srfunksensei/MIPS/(list of files, cad)

Other CAD files:
source/8051/program8051/STARTUP.OBJ
source/8051/program8051/program8051.OBJ
source/8051/program8051/program.OBJ
