srfunksensei/MIPS/source/8051/kasa8051/16_segmentLED.sch

## KiCad design source/8051/kasa8051/16_segmentLED.sch (2018-07-15)

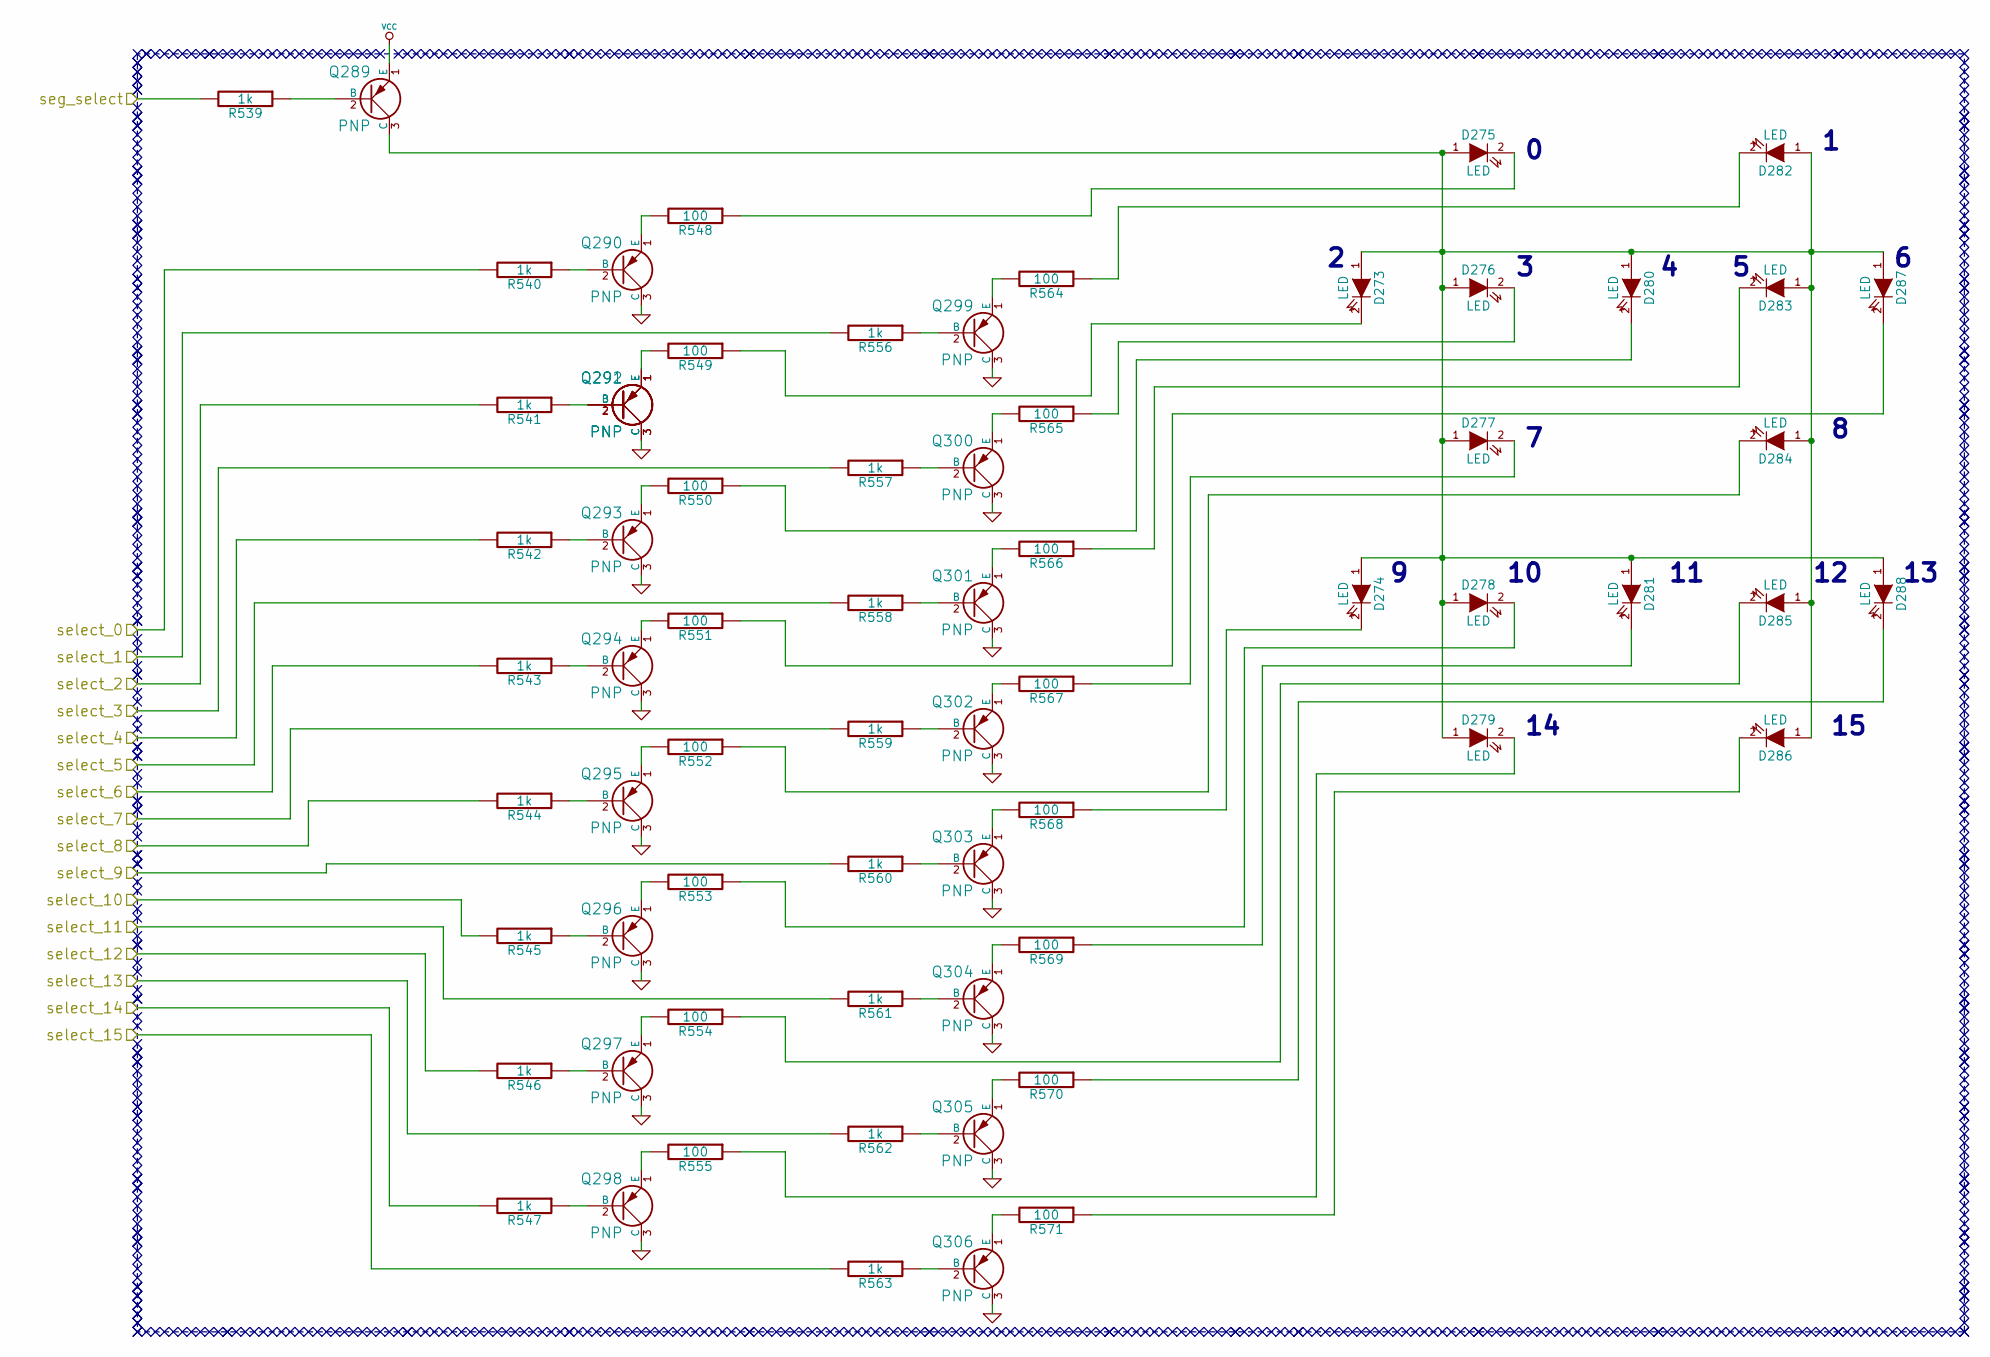
[picture p5: schematic 16_segmentLED.sch]

Parts:
D273, D274, D275, D276, D277, D278, D279, D280, D281, D282, D283, D284, D285, D286, D287, D288: LED
Q289, Q290, Q291, Q292, Q293, Q294, Q295, Q296, Q297, Q298, Q299, Q300, Q301, Q302, Q303, Q304, Q305, Q306: PNP
R539, R540, R541, R542, R543, R544, R545, R546, R547, R556, R557, R558, R559, R560, R561, R562, R563: 1k
R548, R549, R550, R551, R552, R553, R554, R555, R564, R565, R566, R567, R568, R569, R570, R571: 100

Connections:
GNDA: Q290.3 (C), Q291.3 (C), Q292.3 (C), Q293.3 (C), Q294.3 (C), Q295.3 (C), Q296.3 (C), Q297.3 (C), Q298.3 (C), Q299.3 (C), Q300.3 (C), Q301.3 (C), Q302.3 (C), Q303.3 (C), Q304.3 (C), Q305.3 (C), Q306.3 (C)
unnamed: D273.1 (A), D274.1 (A), D275.1 (A), D276.1 (A), D277.1 (A), D278.1 (A), D279.1 (A), D280.1 (A), D281.1 (A), D282.1 (A), D283.1 (A), D284.1 (A), D285.1 (A), D286.1 (A), D287.1 (A), D288.1 (A), Q289.3 (C)
unnamed: D273.2 (K), R549.1
unnamed: D274.2 (K), R568.1
unnamed: D275.2 (K), R548.1
unnamed: D276.2 (K), R565.1
unnamed: D277.2 (K), R567.1
unnamed: D278.2 (K), R553.1
unnamed: D279.2 (K), R555.1
unnamed: D280.2 (K), R550.1
unnamed: D281.2 (K), R569.1
unnamed: D282.2 (K), R564.1
unnamed: D283.2 (K), R566.1
unnamed: D284.2 (K), R552.1
unnamed: D285.2 (K), R554.1
unnamed: D286.2 (K), R571.1
unnamed: D287.2 (K), R551.1
unnamed: D288.2 (K), R570.1
unnamed: Q289.2 (B), R539.1
unnamed: Q290.1 (E), R548.2
unnamed: Q290.2 (B), R540.1
unnamed: Q291.1 (E), Q292.1 (E), R549.2
unnamed: Q291.2 (B), Q292.2 (B), R541.1
unnamed: Q293.1 (E), R550.2
unnamed: Q293.2 (B), R542.1
unnamed: Q294.1 (E), R551.2
unnamed: Q294.2 (B), R543.1
unnamed: Q295.1 (E), R552.2
unnamed: Q295.2 (B), R544.1
unnamed: Q296.1 (E), R553.2
unnamed: Q296.2 (B), R545.1
unnamed: Q297.1 (E), R554.2
unnamed: Q297.2 (B), R546.1
unnamed: Q298.1 (E), R555.2
unnamed: Q298.2 (B), R547.1
unnamed: Q299.1 (E), R564.2
unnamed: Q299.2 (B), R556.1
unnamed: Q300.1 (E), R565.2
unnamed: Q300.2 (B), R557.1
unnamed: Q301.1 (E), R566.2
unnamed: Q301.2 (B), R558.1
unnamed: Q302.1 (E), R567.2
unnamed: Q302.2 (B), R559.1
unnamed: Q303.1 (E), R568.2
unnamed: Q303.2 (B), R560.1
unnamed: Q304.1 (E), R569.2
unnamed: Q304.2 (B), R561.1
unnamed: Q305.1 (E), R570.2
unnamed: Q305.2 (B), R562.1
unnamed: Q306.1 (E), R571.2
unnamed: Q306.2 (B), R563.1
VCC: Q289.1 (E)
seg_select: R539.2
select_0: R540.2
select_1: R556.2
select_2: R541.2
select_3: R557.2
select_4: R542.2
select_5: R558.2
select_6: R543.2
select_7: R559.2
select_8: R544.2
select_9: R560.2
select_10: R545.2
select_11: R561.2
select_12: R546.2
select_13: R562.2
select_14: R547.2
select_15: R563.2
