srfunksensei/MIPS/source/8051/kasa8051/8051.sch

## KiCad design source/8051/kasa8051/8051.sch (2018-07-15)

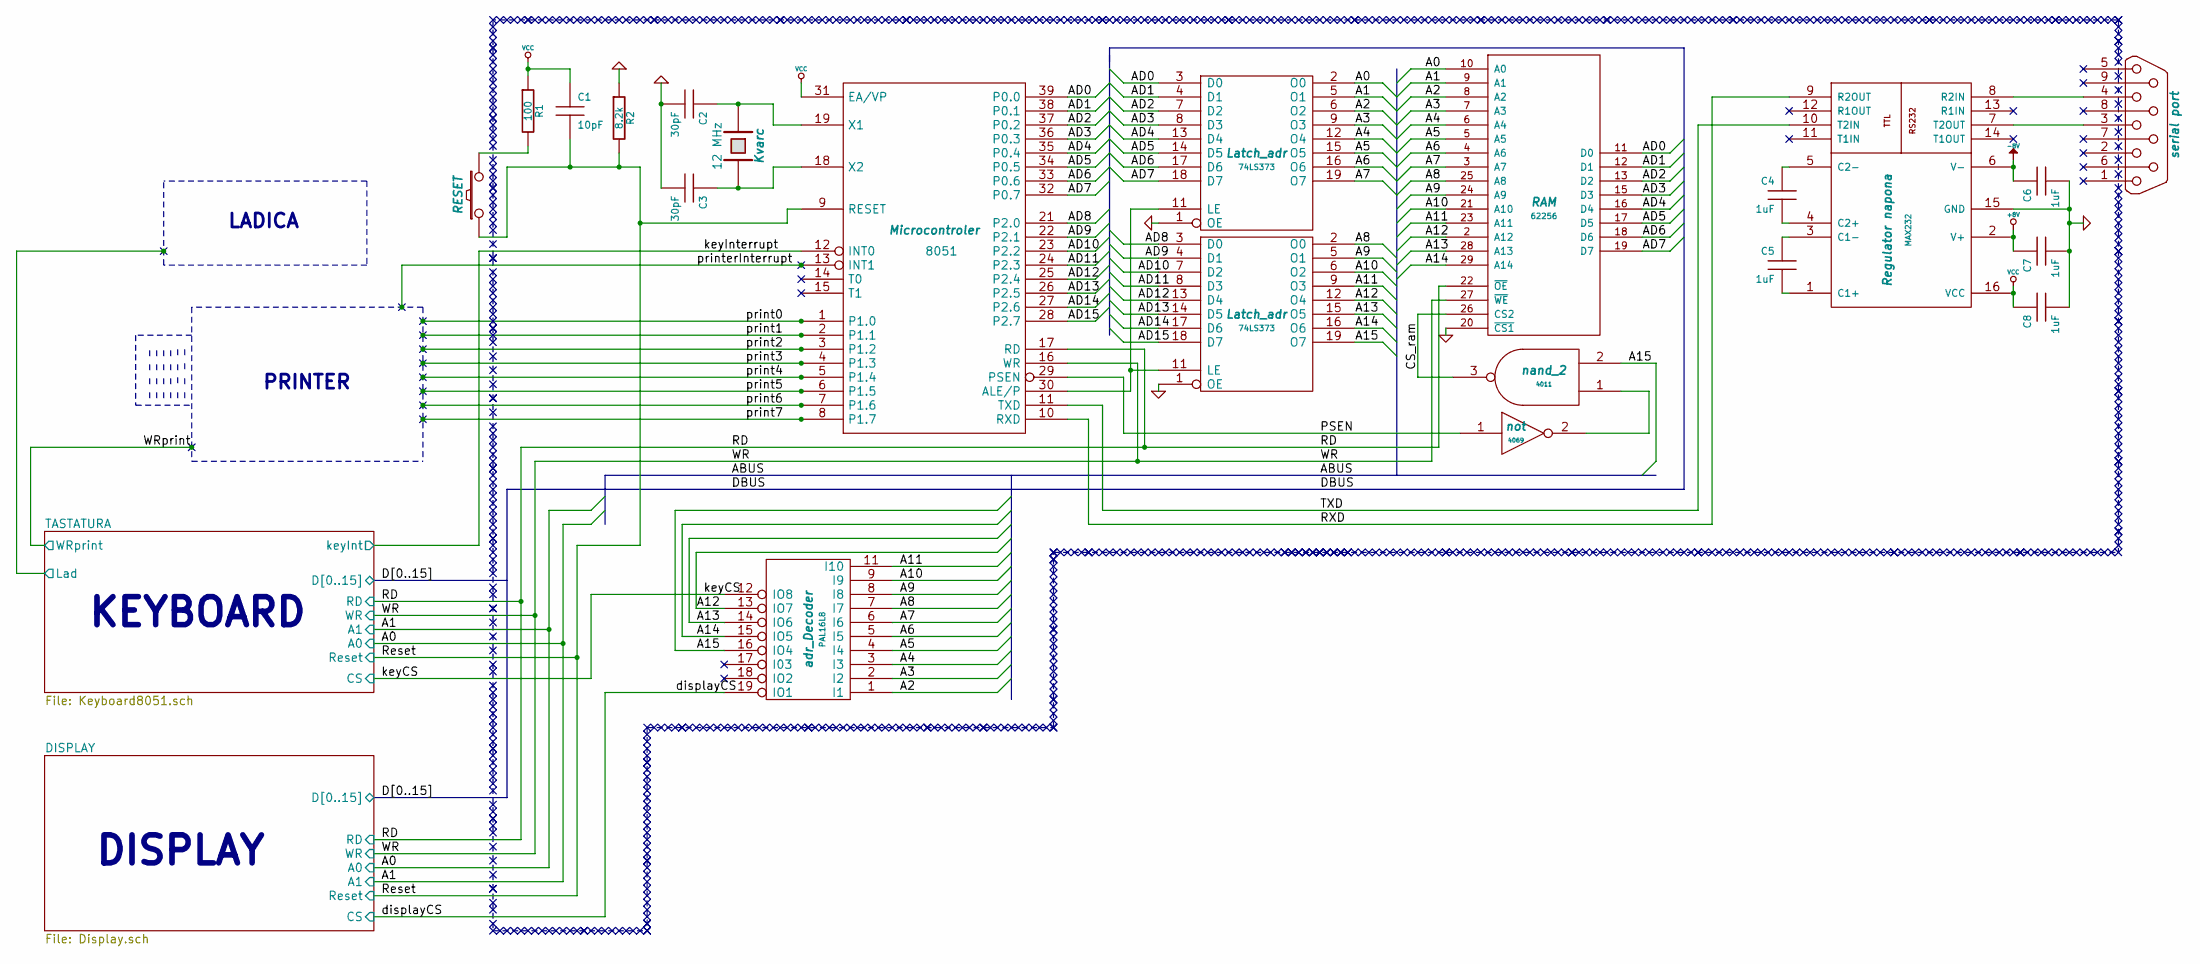
[picture p6: schematic 8051.sch]

Parts:
C1: 10pF
C2, C3: 30pF
C4, C5, C6, C7, C8: 1uF
KVARC1: 12 MHz; Kvarc
NOT1: 4069; not
R1: 100
R2: 8.2k
RAM1: 62256; RAM
SW1: RESET
U1: 4011; nand_2
U2: MAX232; Regulator napona
adr_decode1: PAL16L8; adr_Decoder
latch_adr1, latch_adr2: 74LS373; Latch_adr
mikrokontroler1: 8051; Microcontroler
serijski_port1: DB9; serial port

Connections:
+8V: C7.1, U2.2 (V+)
-8V: C6.1, U2.6 (V-)
A0: RAM1.9 (A1), RAM1.10 (A0), latch_adr1.2 (O0), latch_adr1.5 (O1)
A2: RAM1.8 (A2), adr_decode1.1 (I1), latch_adr1.6 (O2)
A3: RAM1.7 (A3), adr_decode1.2 (I2), latch_adr1.9 (O3)
A4: RAM1.6 (A4), adr_decode1.3 (I3), latch_adr1.12 (O4)
A5: RAM1.5 (A5), adr_decode1.4 (I4), latch_adr1.15 (O5)
A6: RAM1.4 (A6), adr_decode1.5 (I5), latch_adr1.16 (O6)
A7: RAM1.3 (A7), adr_decode1.6 (I6), latch_adr1.19 (O7)
A8: RAM1.25 (A8), adr_decode1.7 (I7), latch_adr2.2 (O0)
A9: RAM1.24 (A9), adr_decode1.8 (I8), latch_adr2.5 (O1)
A10: RAM1.21 (A10), adr_decode1.9 (I9), latch_adr2.6 (O2)
A11: RAM1.23 (A11), adr_decode1.11 (I10), latch_adr2.9 (O3)
A12: RAM1.2 (A12), adr_decode1.13 (IO7), latch_adr2.12 (O4)
A13: RAM1.28 (A13), adr_decode1.14 (IO6), latch_adr2.15 (O5)
A14: RAM1.29 (A14), adr_decode1.15 (IO5), latch_adr2.16 (O6)
A15: U1.2, adr_decode1.16 (IO4), latch_adr2.19 (O7)
AD0: RAM1.11 (D0), latch_adr1.3 (D0), mikrokontroler1.39 (P0.0)
AD1: RAM1.12 (D1), latch_adr1.4 (D1), mikrokontroler1.38 (P0.1)
AD2: RAM1.13 (D2), latch_adr1.7 (D2), mikrokontroler1.37 (P0.2)
AD3: RAM1.15 (D3), latch_adr1.8 (D3), mikrokontroler1.36 (P0.3)
AD4: RAM1.16 (D4), latch_adr1.13 (D4), mikrokontroler1.35 (P0.4)
AD5: RAM1.17 (D5), latch_adr1.14 (D5), mikrokontroler1.34 (P0.5)
AD6: RAM1.18 (D6), latch_adr1.17 (D6), mikrokontroler1.33 (P0.6)
AD7: RAM1.19 (D7), latch_adr1.18 (D7), mikrokontroler1.32 (P0.7)
AD8: latch_adr2.3 (D0), mikrokontroler1.21 (P2.0)
AD9: latch_adr2.4 (D1), mikrokontroler1.22 (P2.1)
AD10: latch_adr2.7 (D2), mikrokontroler1.23 (P2.2)
AD11: latch_adr2.8 (D3), mikrokontroler1.24 (P2.3)
AD12: latch_adr2.13 (D4), mikrokontroler1.25 (P2.4)
AD13: latch_adr2.14 (D5), mikrokontroler1.26 (P2.5)
AD14: latch_adr2.17 (D6), mikrokontroler1.27 (P2.6)
AD15: latch_adr2.18 (D7), mikrokontroler1.28 (P2.7)
CS_ram: RAM1.26 (CS2), U1.3
GND: C2.2, C3.2, C6.2, C7.2, C8.2, R2.1, U2.15 (GND), latch_adr2.1 (OE)
GNDA: RAM1.20 (~CS1), latch_adr1.1 (OE)
unnamed: C2.1, KVARC1.1, mikrokontroler1.19 (X1)
unnamed: C3.1, KVARC1.2, mikrokontroler1.18 (X2)
unnamed: C4.1, U2.5 (C2-)
unnamed: C4.2, U2.4 (C2+)
unnamed: C5.1, U2.3 (C1-)
unnamed: C5.2, U2.1 (C1+)
unnamed: NOT1.2, U1.1
unnamed: R1.2, SW1.2
unnamed: U2.7 (T2OUT), serijski_port1.3
unnamed: U2.8 (R2IN), serijski_port1.4
unnamed: latch_adr1.11 (LE), latch_adr2.11 (LE), mikrokontroler1.30 (ALE/P)
PSEN: NOT1.1, mikrokontroler1.29 (PSEN)
RD: RAM1.22 (~OE), mikrokontroler1.17 (RD)
RXD: U2.9 (R2OUT), mikrokontroler1.10 (RXD)
Reset: C1.2, R2.2, SW1.1, mikrokontroler1.9 (RESET)
TXD: U2.10 (T2IN), mikrokontroler1.11 (TXD)
VCC: C1.1, C8.1, R1.1, U2.16 (VCC), mikrokontroler1.31 (EA/VP)
WR: RAM1.27 (~WE), mikrokontroler1.16 (WR)
displayCS: adr_decode1.19 (IO1)
keyCS: adr_decode1.12 (IO8)
keyInterrupt: mikrokontroler1.12 (INT0)
print0: mikrokontroler1.1 (P1.0)
print1: mikrokontroler1.2 (P1.1)
print2: mikrokontroler1.3 (P1.2)
print3: mikrokontroler1.4 (P1.3)
print4: mikrokontroler1.5 (P1.4)
print5: mikrokontroler1.6 (P1.5)
print6: mikrokontroler1.7 (P1.6)
print7: mikrokontroler1.8 (P1.7)
printerInterrupt: mikrokontroler1.13 (INT1)

Notes on the sheet:
PRINTER
LADICA
DISPLAY
KEYBOARD
