srfunksensei/MIPS/source/8051/kasa8051/Display.sch

## KiCad design source/8051/kasa8051/Display.sch (2018-07-15)

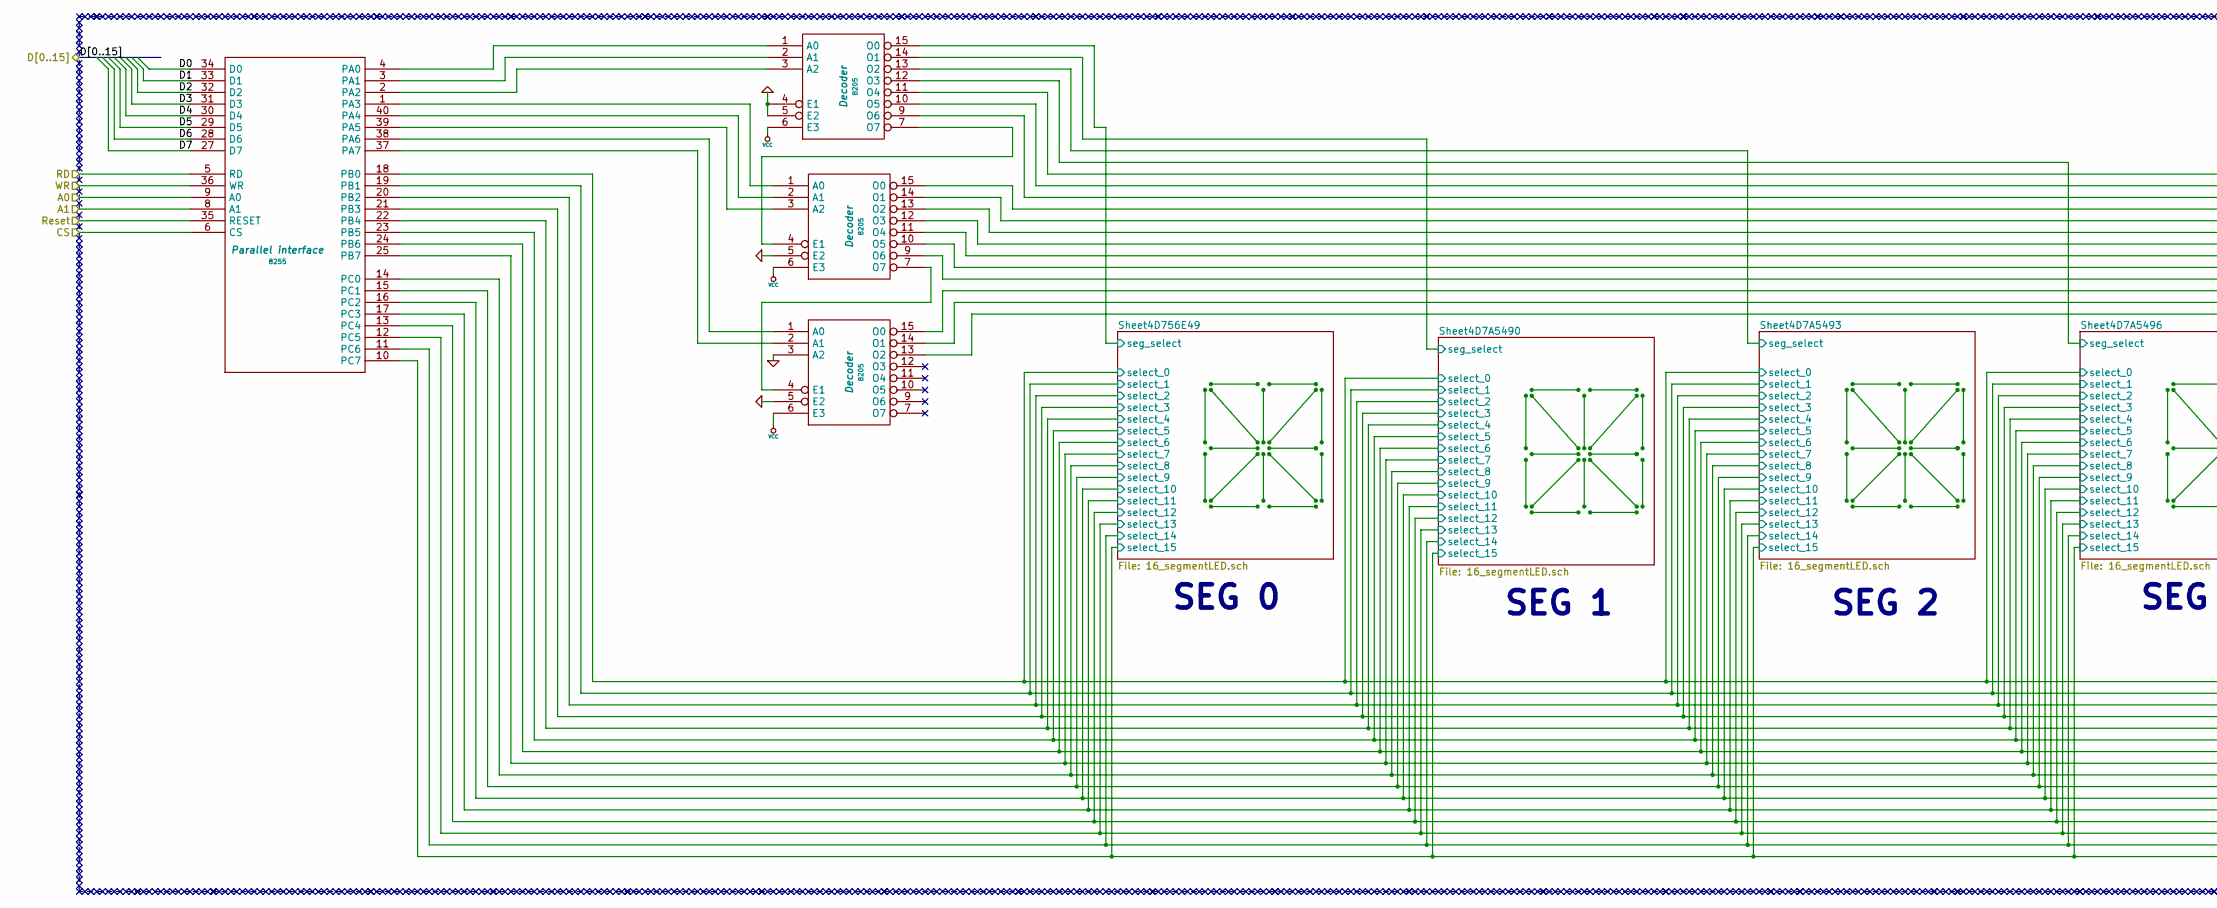
[picture p7: schematic Display.sch, part in row 1, column 1]

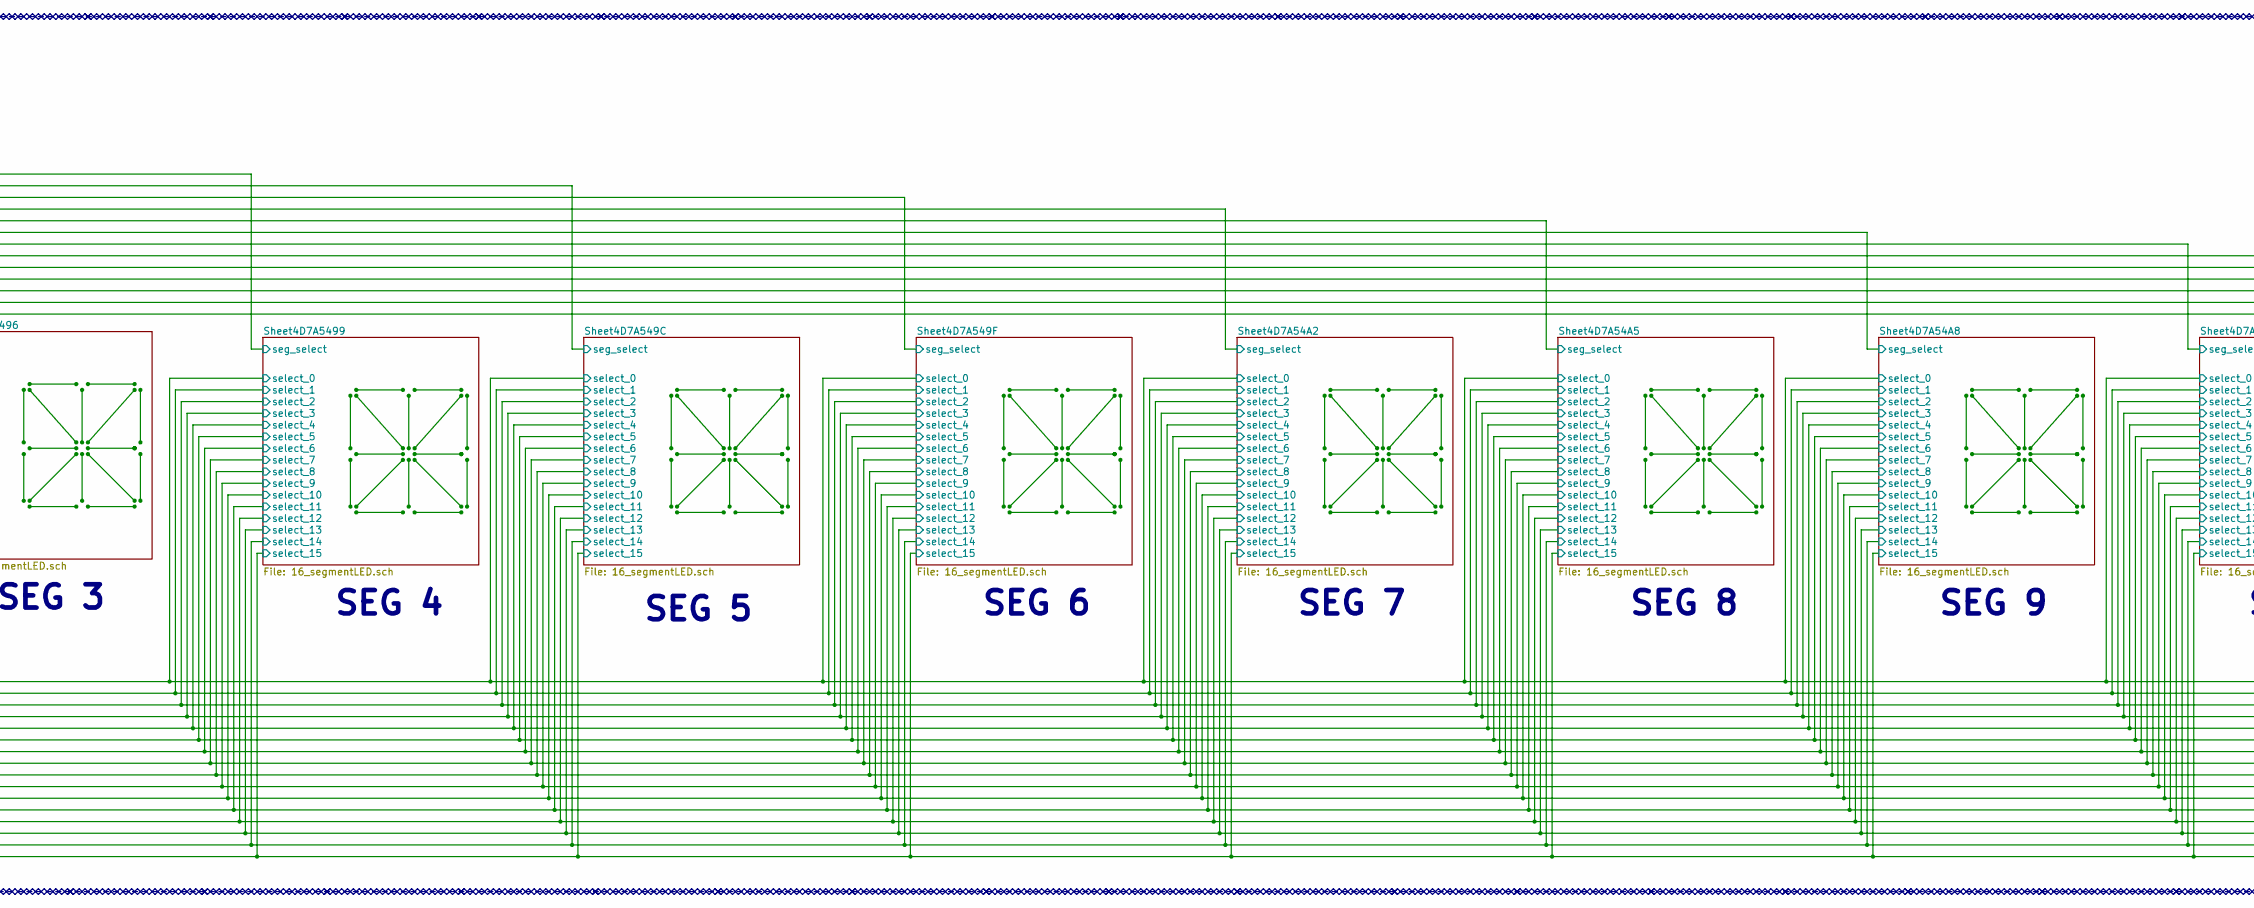
[picture p8: schematic Display.sch, part in row 1, column 2]

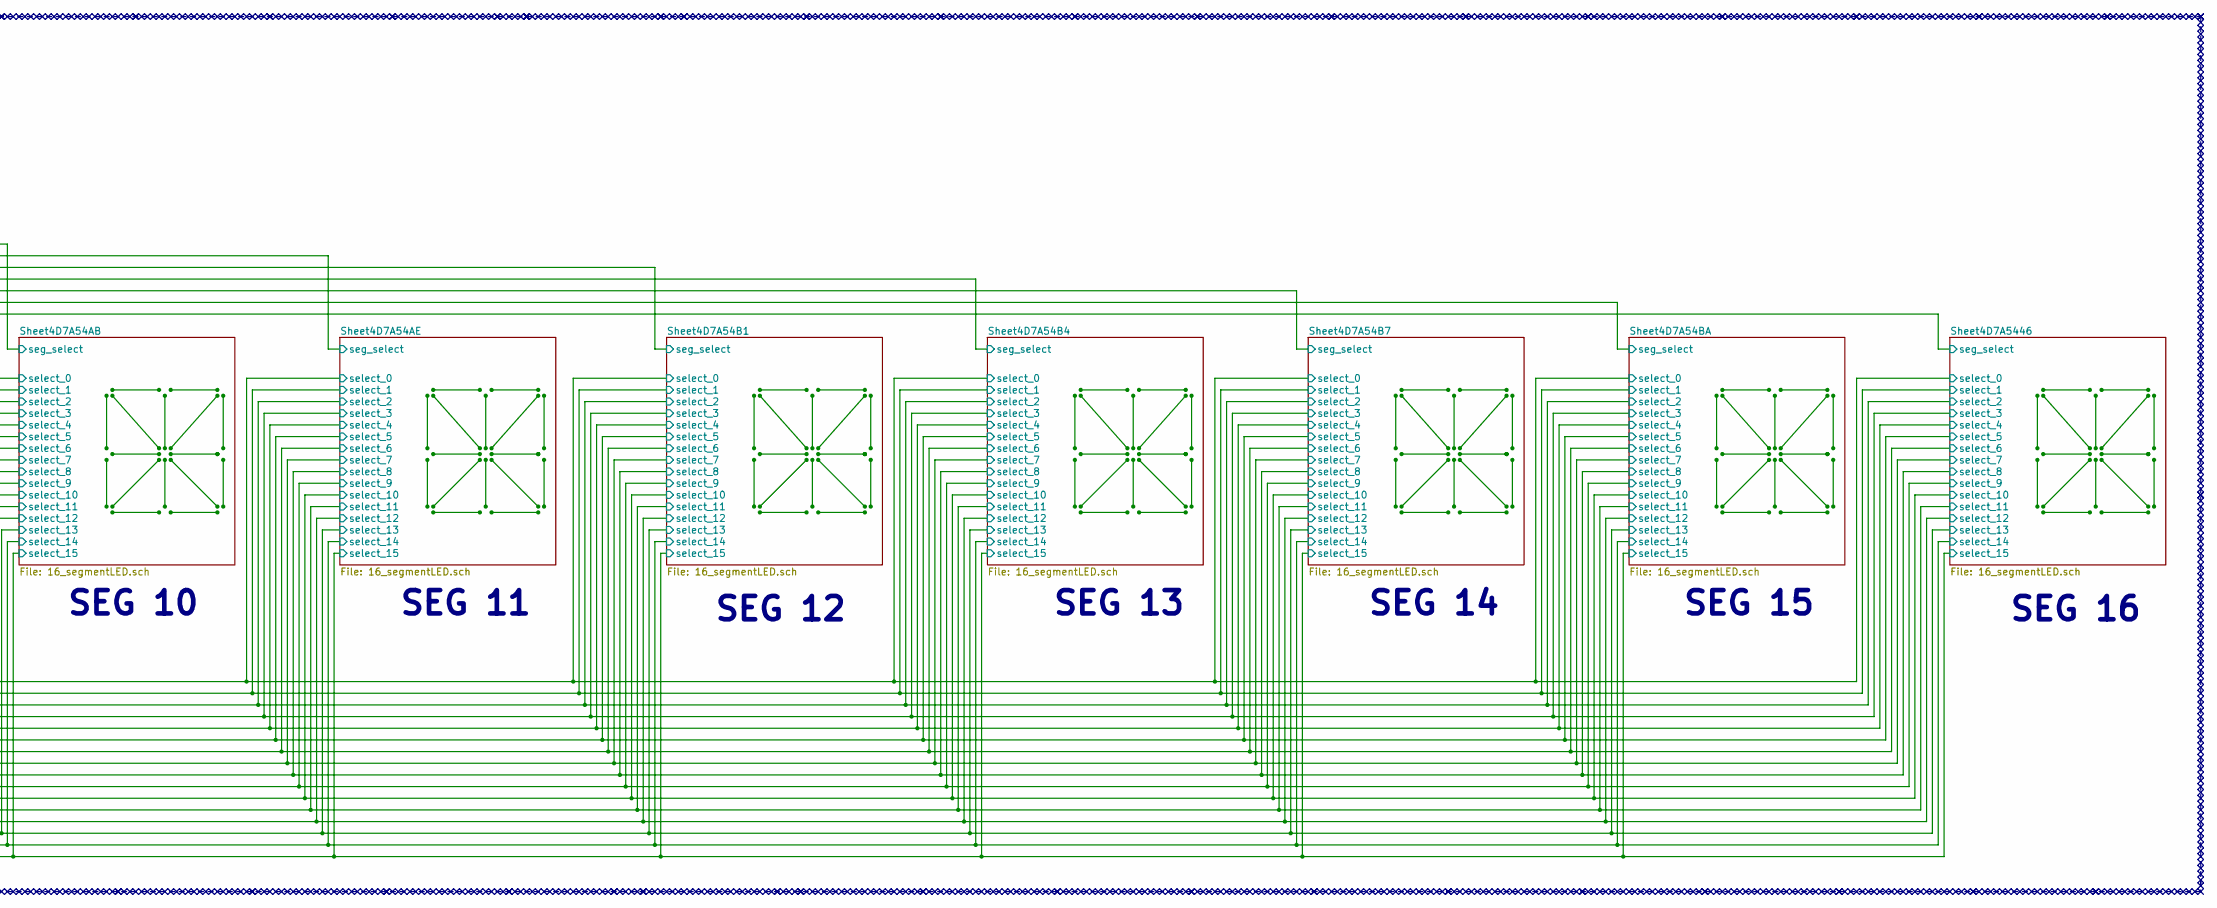
[picture p9: schematic Display.sch, part in row 1, column 3]

Parts:
decoder1, decoder2, decoder3: 8205; Decoder
parallel_interface2: 8255; Parallel interface

Connections:
A0: parallel_interface2.9 (A0)
A1: parallel_interface2.8 (A1)
CS: parallel_interface2.6 (CS)
D0: parallel_interface2.34 (D0)
D1: parallel_interface2.33 (D1)
D2: parallel_interface2.32 (D2)
D3: parallel_interface2.31 (D3)
D4: parallel_interface2.30 (D4)
D5: parallel_interface2.29 (D5)
D6: parallel_interface2.28 (D6)
D7: parallel_interface2.27 (D7)
GND: decoder1.4 (E1), decoder1.5 (E2), decoder2.5 (E2), decoder3.3 (A2), decoder3.5 (E2)
unnamed: decoder1.1 (A0), parallel_interface2.4 (PA0)
unnamed: decoder1.2 (A1), parallel_interface2.3 (PA1)
unnamed: decoder1.3 (A2), parallel_interface2.2 (PA2)
unnamed: decoder1.7 (O7), decoder2.4 (E1)
unnamed: decoder2.1 (A0), parallel_interface2.1 (PA3)
unnamed: decoder2.2 (A1), parallel_interface2.40 (PA4)
unnamed: decoder2.3 (A2), parallel_interface2.39 (PA5)
unnamed: decoder2.7 (O7), decoder3.4 (E1)
unnamed: decoder3.1 (A0), parallel_interface2.38 (PA6)
unnamed: decoder3.2 (A1), parallel_interface2.37 (PA7)
RD: parallel_interface2.5 (RD)
Reset: parallel_interface2.35 (RESET)
VCC: decoder1.6 (E3), decoder2.6 (E3), decoder3.6 (E3)
WR: parallel_interface2.36 (WR)
seg_select: decoder1.9 (O6), decoder1.10 (O5), decoder1.11 (O4), decoder1.12 (O3), decoder1.13 (O2), decoder1.14 (O1), decoder1.15 (O0), decoder2.9 (O6), decoder2.10 (O5), decoder2.11 (O4), decoder2.12 (O3), decoder2.13 (O2), decoder2.14 (O1), decoder2.15 (O0), decoder3.13 (O2), decoder3.14 (O1), decoder3.15 (O0)
select_0: parallel_interface2.18 (PB0)
select_1: parallel_interface2.19 (PB1)
select_2: parallel_interface2.20 (PB2)
select_3: parallel_interface2.21 (PB3)
select_4: parallel_interface2.22 (PB4)
select_5: parallel_interface2.23 (PB5)
select_6: parallel_interface2.24 (PB6)
select_7: parallel_interface2.25 (PB7)
select_8: parallel_interface2.14 (PC0)
select_9: parallel_interface2.15 (PC1)
select_10: parallel_interface2.16 (PC2)
select_11: parallel_interface2.17 (PC3)
select_12: parallel_interface2.13 (PC4)
select_13: parallel_interface2.12 (PC5)
select_14: parallel_interface2.11 (PC6)
select_15: parallel_interface2.10 (PC7)

Notes on the sheet:
SEG 16
SEG 15
SEG 14
SEG 13
SEG 12
SEG 11
SEG 10
SEG 9
SEG 8
SEG 7
SEG 6
SEG 5
SEG 4
SEG 3
SEG 2
SEG 1
SEG 0
