srfunksensei/MIPS/source/8051/kasa8051/Keyboard8051.sch

## KiCad design source/8051/kasa8051/Keyboard8051.sch (2018-07-15)

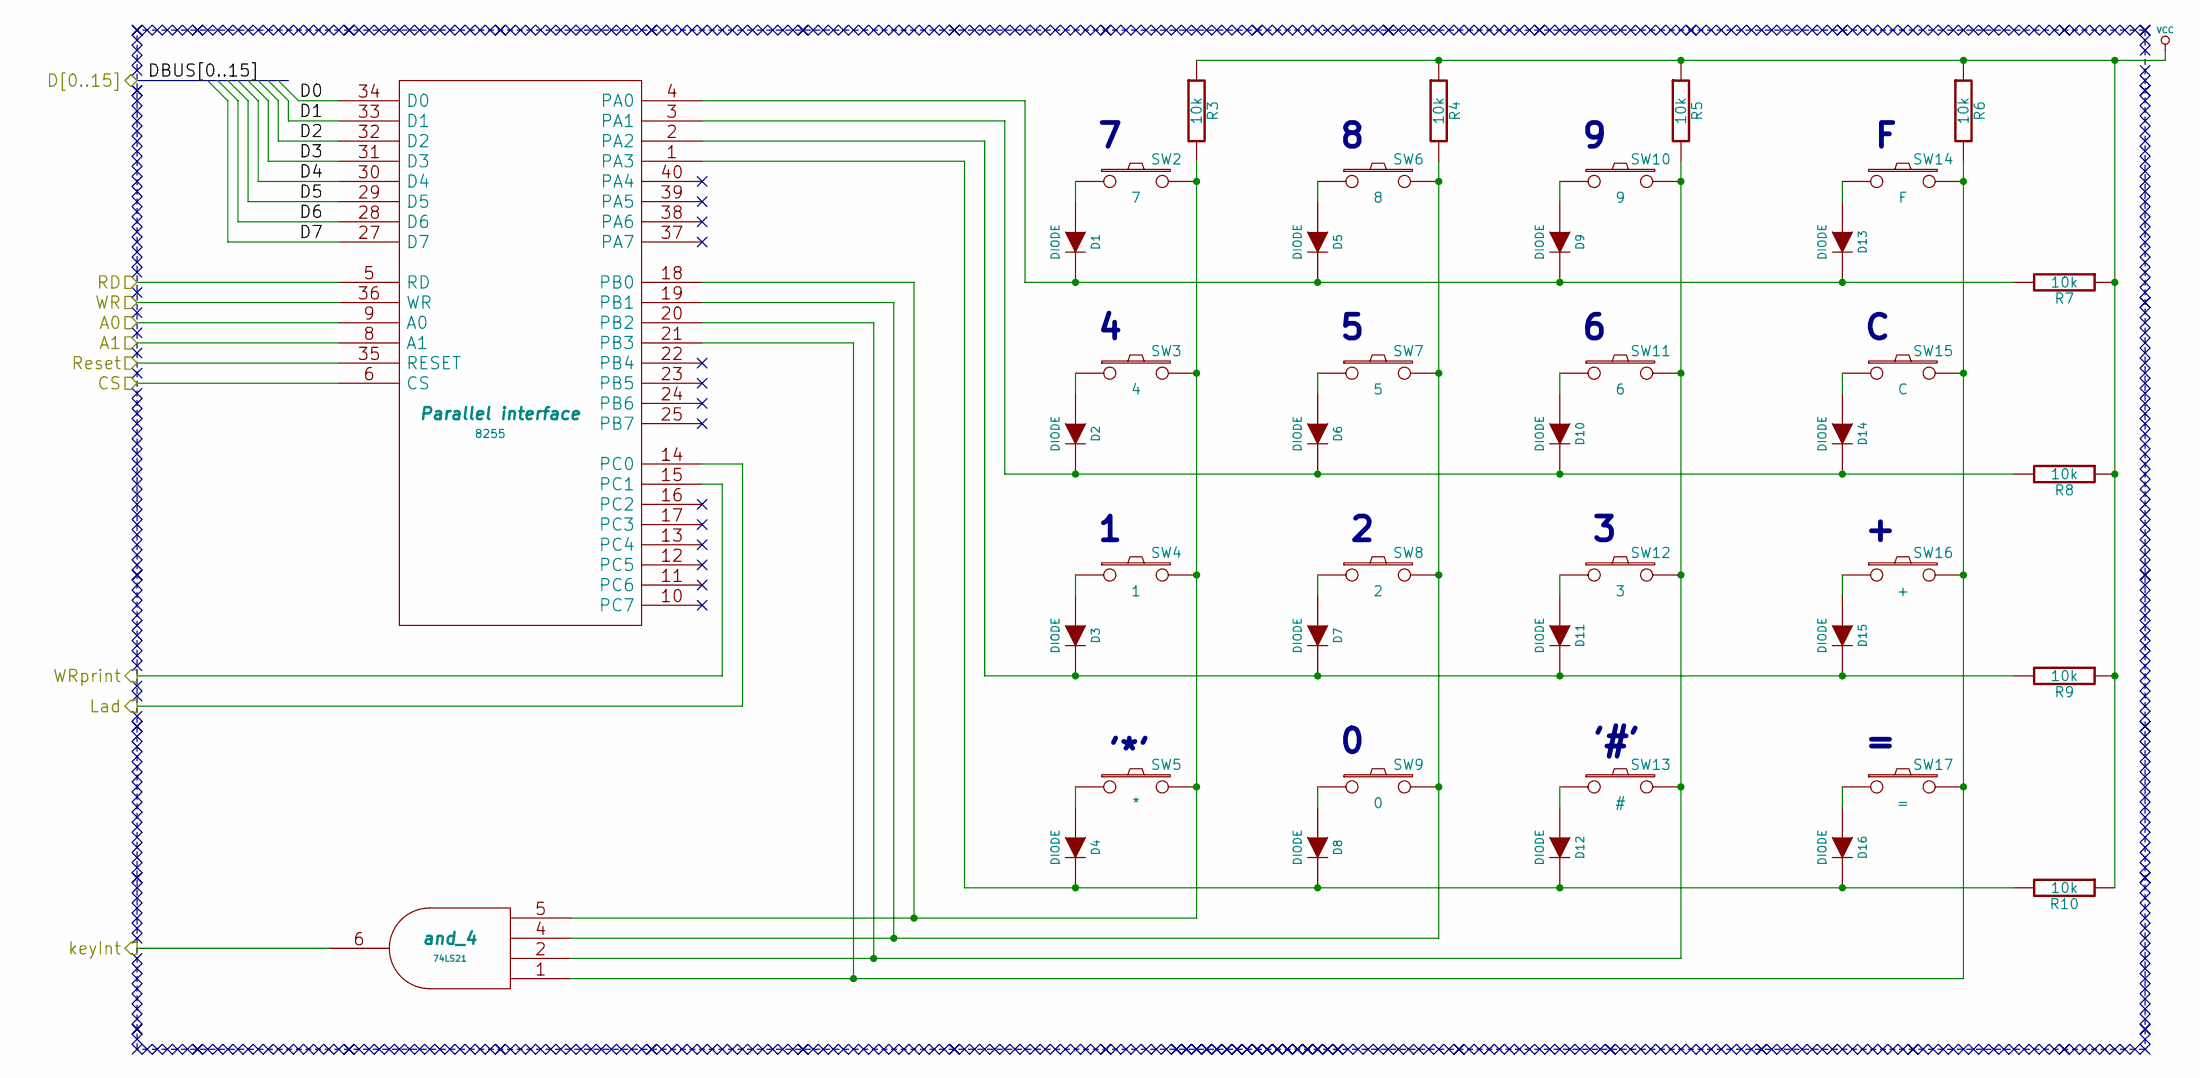
[picture p10: schematic Keyboard8051.sch]

Parts:
D1, D2, D3, D4, D5, D6, D7, D8, D9, D10, D11, D12, D13, D14, D15, D16: DIODE
R3, R4, R5, R6, R7, R8, R9, R10: 10k
SW2: 7
SW3: 4
SW4: 1
SW5: *
SW6: 8
SW7: 5
SW8: 2
SW9: 0
SW10: 9
SW11: 6
SW12: 3
SW13: #
SW14: F
SW15: C
SW16: +
SW17: =
U3: 74LS21; and_4
parallel_interface1: 8255; Parallel interface

Connections:
A0: parallel_interface1.9 (A0)
A1: parallel_interface1.8 (A1)
CS: parallel_interface1.6 (CS)
D0: parallel_interface1.34 (D0)
D1: parallel_interface1.33 (D1)
D2: parallel_interface1.32 (D2)
D3: parallel_interface1.31 (D3)
D4: parallel_interface1.30 (D4)
D5: parallel_interface1.29 (D5)
D6: parallel_interface1.28 (D6)
D7: parallel_interface1.27 (D7)
Lad: parallel_interface1.14 (PC0)
unnamed: D1.1 (A), SW2.1
unnamed: D1.2 (K), D5.2 (K), D9.2 (K), D13.2 (K), R7.2, parallel_interface1.4 (PA0)
unnamed: D2.1 (A), SW3.1
unnamed: D3.1 (A), SW4.1
unnamed: D4.1 (A), SW5.1
unnamed: D5.1 (A), SW6.1
unnamed: D6.1 (A), SW7.1
unnamed: D7.1 (A), SW8.1
unnamed: D8.1 (A), SW9.1
unnamed: D9.1 (A), SW10.1
unnamed: D10.1 (A), SW11.1
unnamed: D2.2 (K), D6.2 (K), D10.2 (K), D14.2 (K), R8.2, parallel_interface1.3 (PA1)
unnamed: D11.1 (A), SW12.1
unnamed: D3.2 (K), D7.2 (K), D11.2 (K), D15.2 (K), R9.2, parallel_interface1.2 (PA2)
unnamed: D12.1 (A), SW13.1
unnamed: D4.2 (K), D8.2 (K), D12.2 (K), D16.2 (K), R10.2, parallel_interface1.1 (PA3)
unnamed: D13.1 (A), SW14.1
unnamed: D14.1 (A), SW15.1
unnamed: D15.1 (A), SW16.1
unnamed: D16.1 (A), SW17.1
unnamed: R3.2, SW2.2, SW3.2, SW4.2, SW5.2, U3.5, parallel_interface1.18 (PB0)
unnamed: R4.2, SW6.2, SW7.2, SW8.2, SW9.2, U3.4, parallel_interface1.19 (PB1)
unnamed: R5.2, SW10.2, SW11.2, SW12.2, SW13.2, U3.2, parallel_interface1.20 (PB2)
unnamed: R6.2, SW14.2, SW15.2, SW16.2, SW17.2, U3.1, parallel_interface1.21 (PB3)
RD: parallel_interface1.5 (RD)
Reset: parallel_interface1.35 (RESET)
VCC: R3.1, R4.1, R5.1, R6.1, R7.1, R8.1, R9.1, R10.1
WR: parallel_interface1.36 (WR)
WRprint: parallel_interface1.15 (PC1)
keyInt: U3.6

Notes on the sheet:
'#'
'*'
