srfunksensei/MIPS/source/8086/kasa8086/8086.sch

## KiCad design source/8086/kasa8086/8086.sch (2018-07-15)

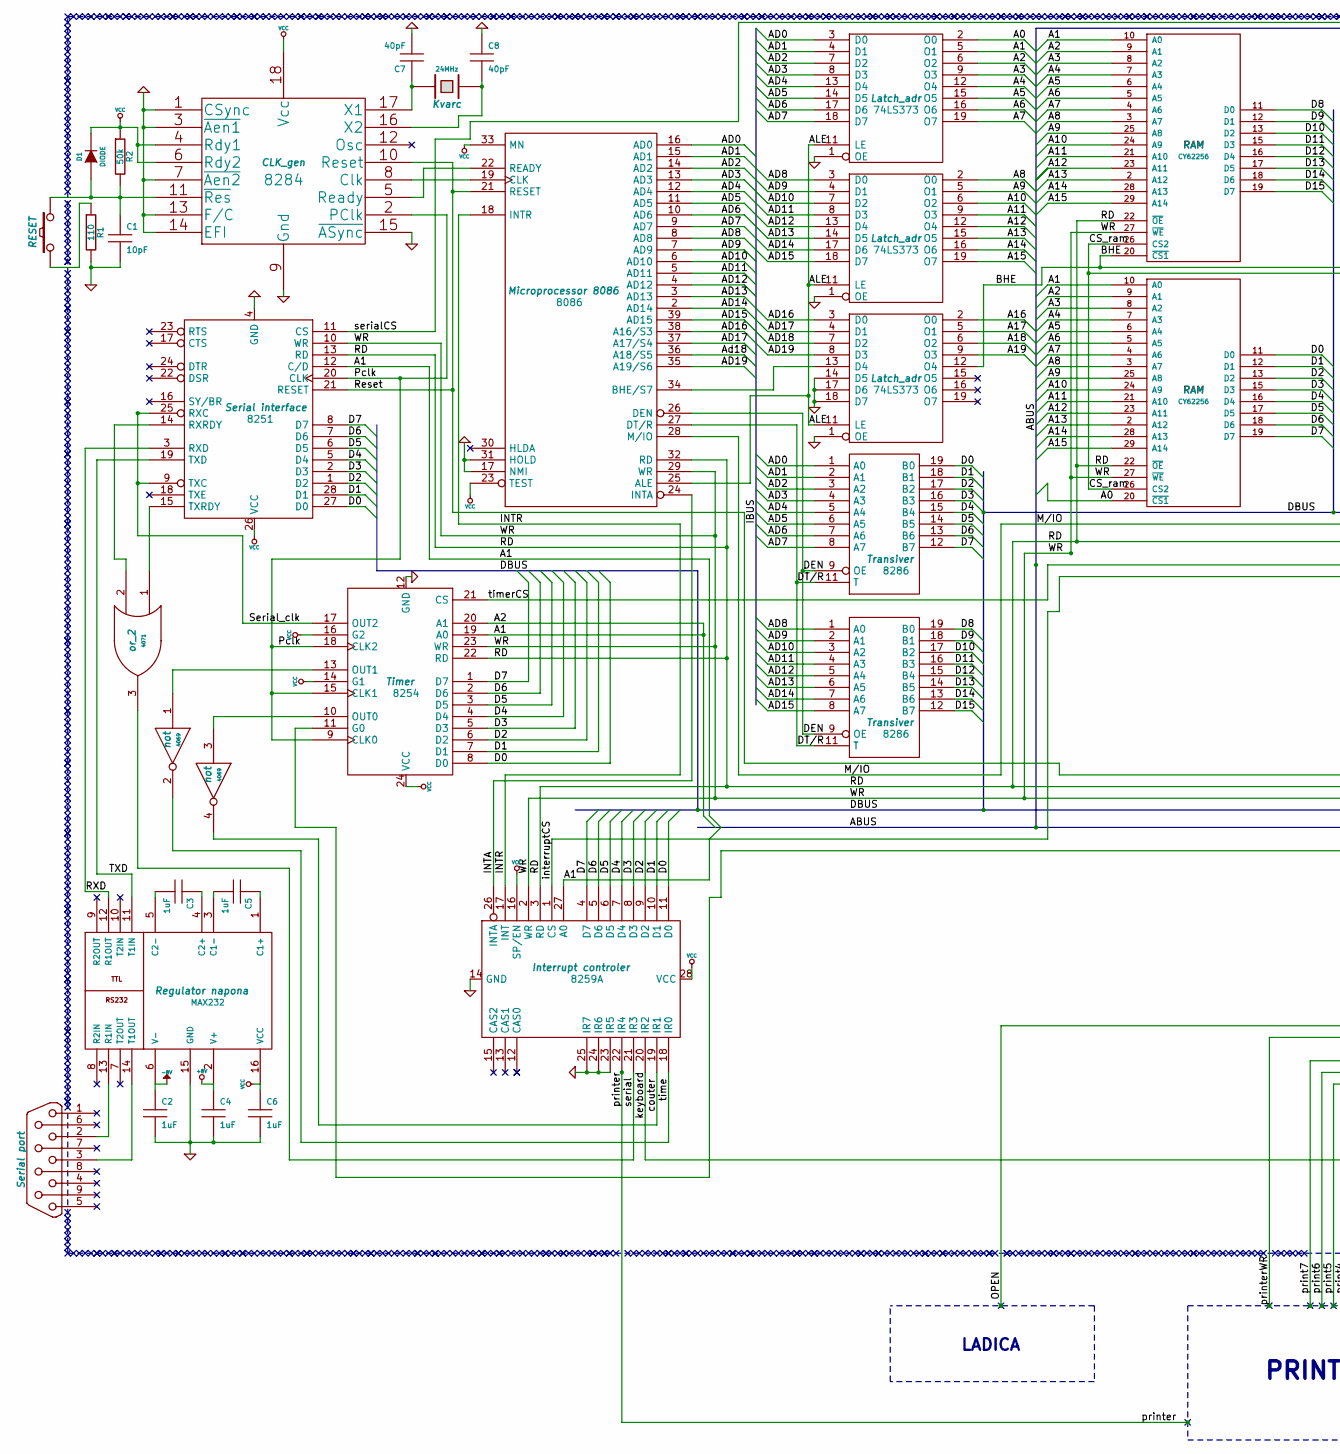
[picture p12: schematic 8086.sch, part in row 1, column 1]

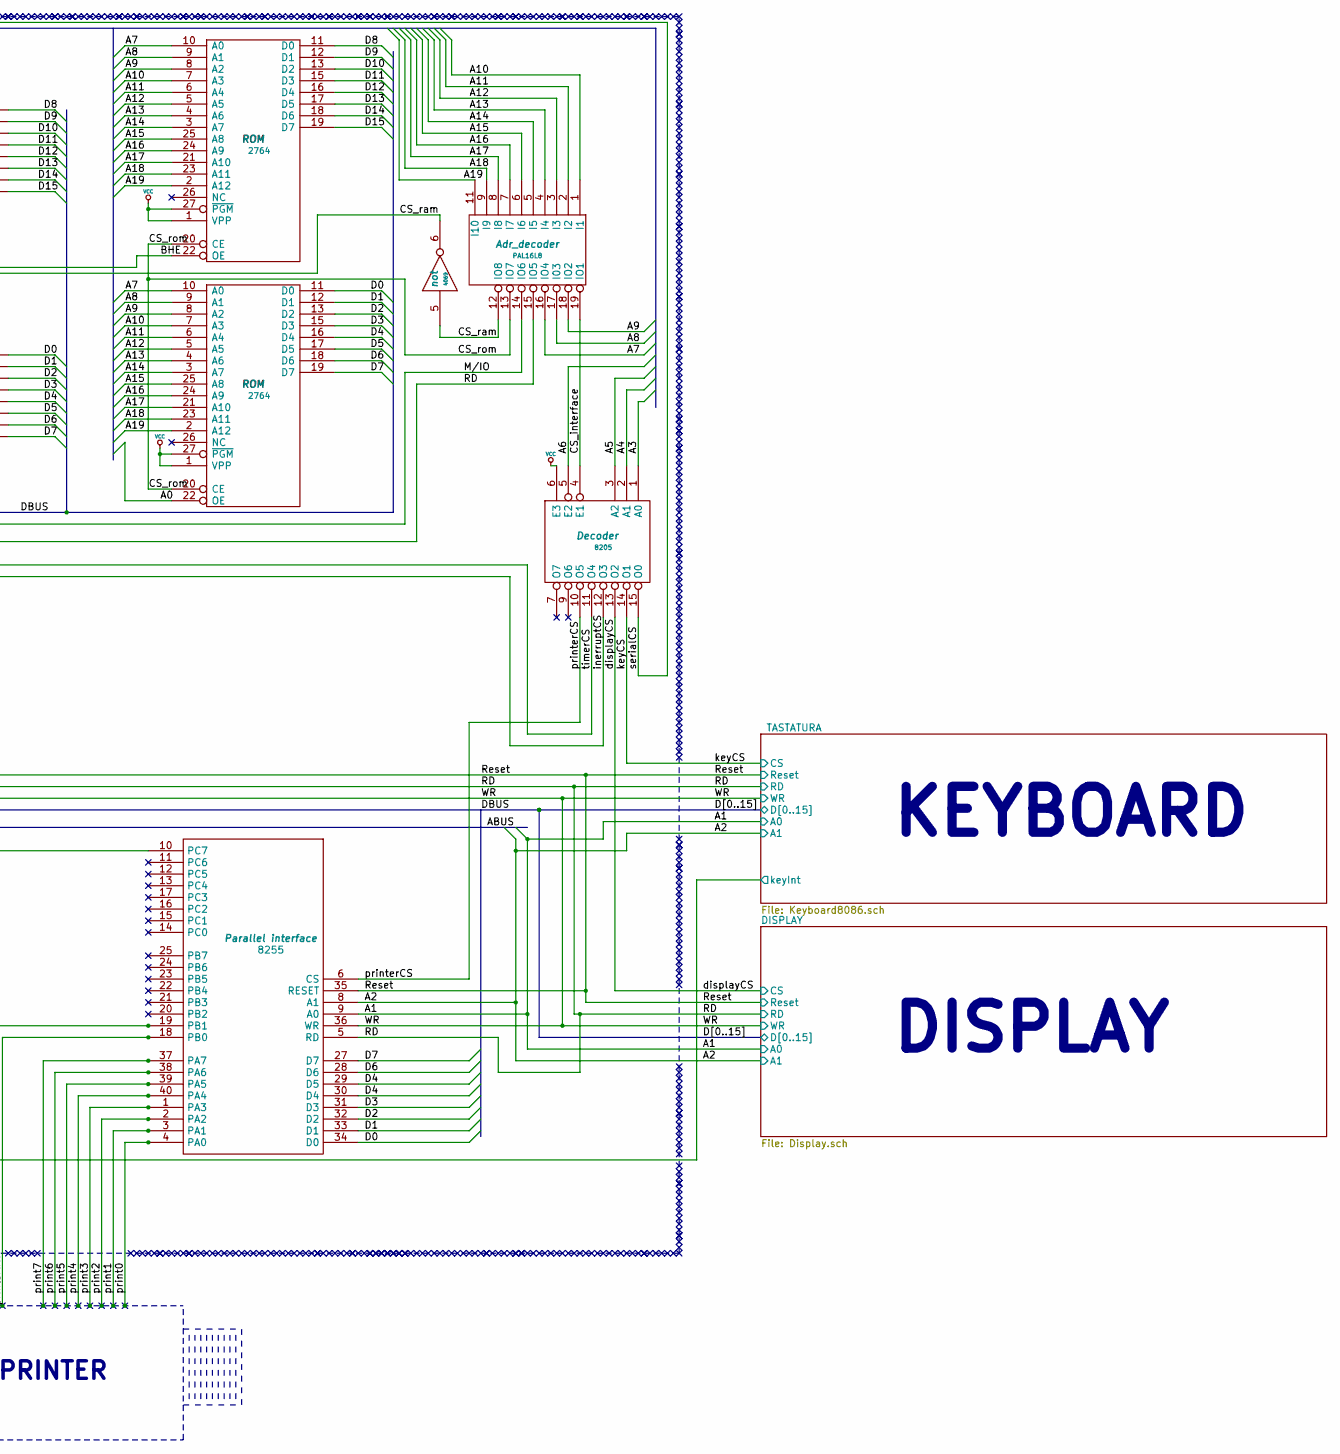
[picture p13: schematic 8086.sch, part in row 1, column 2]

Parts:
C1: 10pF
C2, C3, C4, C5, C6: 1uF
C7, C8: 40pF
D1: DIODE
ILI1: 4071; or_2
Kvarc1: 24MHz; Kvarc
NOT1: 4069; not
R1: 110
R2: 50k
RAM1, RAM2: CY62256; RAM
Reset1: RESET
Serial_port1: DB9; Serial port
adr_decode1: PAL16L8; Adr_decoder
cg1: 8284; CLK_gen
decoder1: 8205; Decoder
kn1: MAX232; Regulator napona
kontroler_prekida1: 8259A; Interrupt controler
latch_adr1, latch_adr2, latch_adr3: 74LS373; Latch_adr
mp1: 8086; Microprocessor 8086
parallel_interface1: 8255; Parallel interface
rom1, rom2: 2764; ROM
si1: 8251; Serial interface
timer1: 8254; Timer
transiver1, transiver2: 8286; Transiver

Connections:
+8V: C4.1, kn1.2 (V+)
-8V: C2.1, kn1.6 (V-)
A0: RAM2.20 (~CS1), latch_adr1.2 (O0), rom2.22 (OE)
A1: RAM1.9 (A1), RAM1.10 (A0), RAM2.9 (A1), RAM2.10 (A0), kontroler_prekida1.27 (A0), latch_adr1.5 (O1), latch_adr1.6 (O2), parallel_interface1.8 (A1), parallel_interface1.9 (A0), si1.12 (C/D), timer1.19 (A0), timer1.20 (A1)
A3: RAM1.8 (A2), RAM2.8 (A2), decoder1.1 (A0), latch_adr1.9 (O3)
A4: RAM1.7 (A3), RAM2.7 (A3), decoder1.2 (A1), latch_adr1.12 (O4)
A5: RAM1.6 (A4), RAM2.6 (A4), decoder1.3 (A2), latch_adr1.15 (O5)
A6: RAM1.5 (A5), RAM2.5 (A5), decoder1.5 (E2), latch_adr1.16 (O6)
A7: RAM1.4 (A6), RAM2.4 (A6), adr_decode1.16 (IO4), latch_adr1.19 (O7), rom1.10 (A0), rom2.10 (A0)
A8: RAM1.3 (A7), RAM2.3 (A7), adr_decode1.17 (I03), latch_adr2.2 (O0), rom1.9 (A1), rom2.9 (A1)
A9: RAM1.25 (A8), RAM2.25 (A8), adr_decode1.18 (IO2), latch_adr2.5 (O1), rom1.8 (A2), rom2.8 (A2)
A10: RAM1.24 (A9), RAM2.24 (A9), adr_decode1.1 (I1), latch_adr2.6 (O2), rom1.7 (A3), rom2.7 (A3)
A11: RAM1.21 (A10), RAM2.21 (A10), adr_decode1.2 (I2), latch_adr2.9 (O3), rom1.6 (A4), rom2.6 (A4)
A12: RAM1.23 (A11), RAM2.23 (A11), adr_decode1.3 (I3), latch_adr2.12 (O4), rom1.5 (A5), rom2.5 (A5)
A13: RAM1.2 (A12), RAM2.2 (A12), adr_decode1.4 (I4), latch_adr2.15 (O5), rom1.4 (A6), rom2.4 (A6)
A14: RAM1.28 (A13), RAM2.28 (A13), adr_decode1.5 (I5), latch_adr2.16 (O6), rom1.3 (A7), rom2.3 (A7)
A15: RAM1.29 (A14), RAM2.29 (A14), adr_decode1.6 (I6), latch_adr2.19 (O7), rom1.25 (A8), rom2.25 (A8)
A16: adr_decode1.7 (I7), latch_adr3.2 (O0), rom1.24 (A9), rom2.24 (A9)
A17: adr_decode1.8 (I8), latch_adr3.5 (O1), rom1.21 (A10), rom2.21 (A10)
A18: adr_decode1.9 (I9), latch_adr3.6 (O2), rom1.23 (A11), rom2.23 (A11)
A19: adr_decode1.11 (I10), latch_adr3.9 (O3), rom1.2 (A12), rom2.2 (A12)
AD0: latch_adr1.3 (D0), mp1.16 (AD0), transiver1.1 (A0)
AD1: latch_adr1.4 (D1), mp1.15 (AD1), transiver1.2 (A1)
AD2: latch_adr1.7 (D2), mp1.14 (AD2), transiver1.3 (A2)
AD3: latch_adr1.8 (D3), mp1.13 (AD3), transiver1.4 (A3)
AD4: latch_adr1.13 (D4), mp1.12 (AD4), transiver1.5 (A4)
AD5: latch_adr1.14 (D5), mp1.11 (AD5), transiver1.6 (A5)
AD6: latch_adr1.17 (D6), mp1.10 (AD6), transiver1.7 (A6)
AD7: latch_adr1.18 (D7), mp1.9 (AD7), transiver1.8 (A7)
AD8: latch_adr2.3 (D0), mp1.8 (AD8), transiver2.1 (A0)
AD9: latch_adr2.4 (D1), mp1.7 (AD9), transiver2.2 (A1)
AD10: latch_adr2.7 (D2), mp1.6 (AD10), transiver2.3 (A2)
AD11: latch_adr2.8 (D3), mp1.5 (AD11), transiver2.4 (A3)
AD12: latch_adr2.13 (D4), mp1.4 (AD12), transiver2.5 (A4)
AD13: latch_adr2.14 (D5), mp1.3 (AD13), transiver2.6 (A5)
AD14: latch_adr2.17 (D6), mp1.2 (AD14), transiver2.7 (A6)
AD15: latch_adr2.18 (D7), mp1.39 (AD15), transiver2.8 (A7)
AD16: latch_adr3.3 (D0), mp1.38 (A16/S3)
AD17: latch_adr3.4 (D1), mp1.37 (A17/S4)
AD19: latch_adr3.8 (D3), mp1.35 (A19/S6)
ALE: latch_adr1.11 (LE), latch_adr2.11 (LE), latch_adr3.11 (LE), mp1.25 (ALE)
Ad18: latch_adr3.7 (D2), mp1.36 (A18/S5)
BHE: RAM1.20 (~CS1), latch_adr3.12 (O4), rom1.22 (OE)
CS_interface: adr_decode1.19 (IO1), decoder1.4 (E1)
CS_ram: NOT1.5, NOT1.6, RAM1.26 (CS2), RAM2.26 (CS2), adr_decode1.12 (IO8)
CS_rom: adr_decode1.13 (IO7), rom1.20 (CE), rom2.20 (CE)
D0: RAM2.11 (D0), kontroler_prekida1.11 (D0), parallel_interface1.34 (D0), rom2.11 (D0), si1.27 (D0), timer1.8 (D0), transiver1.19 (B0)
D1: RAM2.12 (D1), kontroler_prekida1.10 (D1), parallel_interface1.33 (D1), rom2.12 (D1), si1.28 (D1), timer1.7 (D1), transiver1.18 (B1)
D2: RAM2.13 (D2), kontroler_prekida1.9 (D2), parallel_interface1.32 (D2), rom2.13 (D2), si1.1 (D2), timer1.6 (D2), transiver1.17 (B2)
D3: RAM2.15 (D3), kontroler_prekida1.8 (D3), parallel_interface1.31 (D3), rom2.15 (D3), si1.2 (D3), timer1.5 (D3), transiver1.16 (B3)
D4: RAM2.16 (D4), kontroler_prekida1.7 (D4), parallel_interface1.29 (D5), parallel_interface1.30 (D4), rom2.16 (D4), si1.5 (D4), timer1.4 (D4), transiver1.15 (B4)
D5: RAM2.17 (D5), kontroler_prekida1.6 (D5), rom2.17 (D5), si1.6 (D5), timer1.3 (D5), transiver1.14 (B5)
D6: RAM2.18 (D6), kontroler_prekida1.5 (D6), parallel_interface1.28 (D6), rom2.18 (D6), si1.7 (D6), timer1.2 (D6), transiver1.13 (B6)
D7: RAM2.19 (D7), kontroler_prekida1.4 (D7), parallel_interface1.27 (D7), rom2.19 (D7), si1.8 (D7), timer1.1 (D7), transiver1.12 (B7)
D8: RAM1.11 (D0), rom1.11 (D0), transiver2.19 (B0)
D9: RAM1.12 (D1), rom1.12 (D1), transiver2.18 (B1)
D10: RAM1.13 (D2), rom1.13 (D2), transiver2.17 (B2)
D11: RAM1.15 (D3), rom1.15 (D3), transiver2.16 (B3)
D12: RAM1.16 (D4), rom1.16 (D4), transiver2.15 (B4)
D13: RAM1.17 (D5), rom1.17 (D5), transiver2.14 (B5)
D14: RAM1.18 (D6), rom1.18 (D6), transiver2.13 (B6)
D15: RAM1.19 (D7), rom1.19 (D7), transiver2.12 (B7)
DEN: mp1.26 (DEN), transiver1.9 (OE), transiver2.9 (OE)
DT/R: mp1.27 (DT/R), transiver1.11 (T), transiver2.11 (T)
GND: C1.2, C2.2, C4.2, C6.2, C7.2, C8.1, R1.2, cg1.1 (CSync), cg1.3 (~Aen1), cg1.7 (~Aen2), cg1.13 (F/C), cg1.14 (EFI), cg1.15 (~ASync), kn1.15 (GND), kontroler_prekida1.14 (GND), kontroler_prekida1.23 (IR5), kontroler_prekida1.24 (IR6), kontroler_prekida1.25 (IR7), latch_adr1.1 (OE), latch_adr2.1 (OE), latch_adr3.1 (OE), latch_adr3.14 (D5), latch_adr3.17 (D6), latch_adr3.18 (D7), mp1.17 (NMI), mp1.31 (HOLD), si1.4 (GND), timer1.12 (GND)
GNDA: cg1.9 (Gnd)
INTA: kontroler_prekida1.26 (INTA), mp1.24 (INTA)
INTR: kontroler_prekida1.17 (INT), mp1.18 (INTR)
M/IO: adr_decode1.14 (IO6), mp1.28 (M/IO)
unnamed: C1.1, D1.1 (A), R2.2, Reset1.2, cg1.11 (~Res)
unnamed: C3.1, kn1.4 (C2+)
unnamed: C3.2, kn1.5 (C2-)
unnamed: C5.1, kn1.1 (C1+)
unnamed: C5.2, kn1.3 (C1-)
unnamed: C7.1, Kvarc1.2, cg1.17 (X1)
unnamed: C8.2, Kvarc1.1, cg1.16 (X2)
unnamed: ILI1.1, si1.15 (TXRDY)
unnamed: ILI1.2, si1.14 (RXRDY)
unnamed: NOT1.1, timer1.13 (OUT1)
unnamed: NOT1.3, timer1.10 (OUT0)
unnamed: R1.1, Reset1.1
unnamed: Serial_port1.2, kn1.13 (R1IN)
unnamed: Serial_port1.3, kn1.14 (T1OUT)
unnamed: cg1.5 (Ready), mp1.22 (READY)
unnamed: cg1.8 (Clk), mp1.19 (CLK)
unnamed: latch_adr3.13 (D4), mp1.34 (BHE/S7)
unnamed: parallel_interface1.10 (PC7), timer1.11 (G0)
OPEN: parallel_interface1.19 (PB1)
Pclk: cg1.2 (PClk), si1.20 (CLK), timer1.9 (CLK0), timer1.15 (CLK1), timer1.18 (CLK2)
RD: RAM1.22 (~OE), RAM2.22 (~OE), adr_decode1.15 (IO5), kontroler_prekida1.3 (RD), mp1.32 (RD), parallel_interface1.5 (RD), si1.13 (RD), timer1.22 (RD)
RXD: kn1.12 (R1OUT), si1.3 (RXD)
Reset: cg1.10 (Reset), mp1.21 (RESET), parallel_interface1.35 (RESET), si1.21 (RESET)
Serial_clk: si1.9 (TXC), si1.25 (RXC), timer1.17 (OUT2)
TXD: kn1.11 (T1IN), si1.19 (TXD)
VCC: C6.1, D1.2 (K), R2.1, cg1.4 (Rdy1), cg1.6 (Rdy2), cg1.18 (Vcc), decoder1.6 (E3), kn1.16 (VCC), kontroler_prekida1.16 (SP/EN), kontroler_prekida1.28 (VCC), mp1.23 (TEST), mp1.33 (MN), rom1.1 (VPP), rom1.27 (~PGM), rom2.1 (VPP), rom2.27 (~PGM), si1.26 (VCC), timer1.14 (G1), timer1.16 (G2), timer1.24 (VCC)
WR: RAM1.27 (~WE), RAM2.27 (~WE), kontroler_prekida1.2 (WR), mp1.29 (WR), parallel_interface1.36 (WR), si1.10 (WR), timer1.23 (WR)
couter: NOT1.4, kontroler_prekida1.19 (IR1)
displayCS: decoder1.13 (O2)
inerruptCS: decoder1.12 (O3), kontroler_prekida1.1 (CS)
keyCS: decoder1.14 (O1)
keyboard: kontroler_prekida1.20 (IR2)
print0: parallel_interface1.4 (PA0)
print1: parallel_interface1.3 (PA1)
print2: parallel_interface1.2 (PA2)
print3: parallel_interface1.1 (PA3)
print4: parallel_interface1.40 (PA4)
print5: parallel_interface1.39 (PA5)
print6: parallel_interface1.38 (PA6)
print7: parallel_interface1.37 (PA7)
printer: kontroler_prekida1.22 (IR4)
printerCS: decoder1.10 (O5), parallel_interface1.6 (CS)
printerWR: parallel_interface1.18 (PB0)
serial: ILI1.3, kontroler_prekida1.21 (IR3)
serialCS: decoder1.15 (O0), si1.11 (CS)
time: NOT1.2, kontroler_prekida1.18 (IR0)
timerCS: decoder1.11 (O4), timer1.21 (CS)

Notes on the sheet:
PRINTER
LADICA
DISPLAY
KEYBOARD
