srfunksensei/MIPS/source/8086/kasa8086/Display.sch

## KiCad design source/8086/kasa8086/Display.sch (2018-07-15)

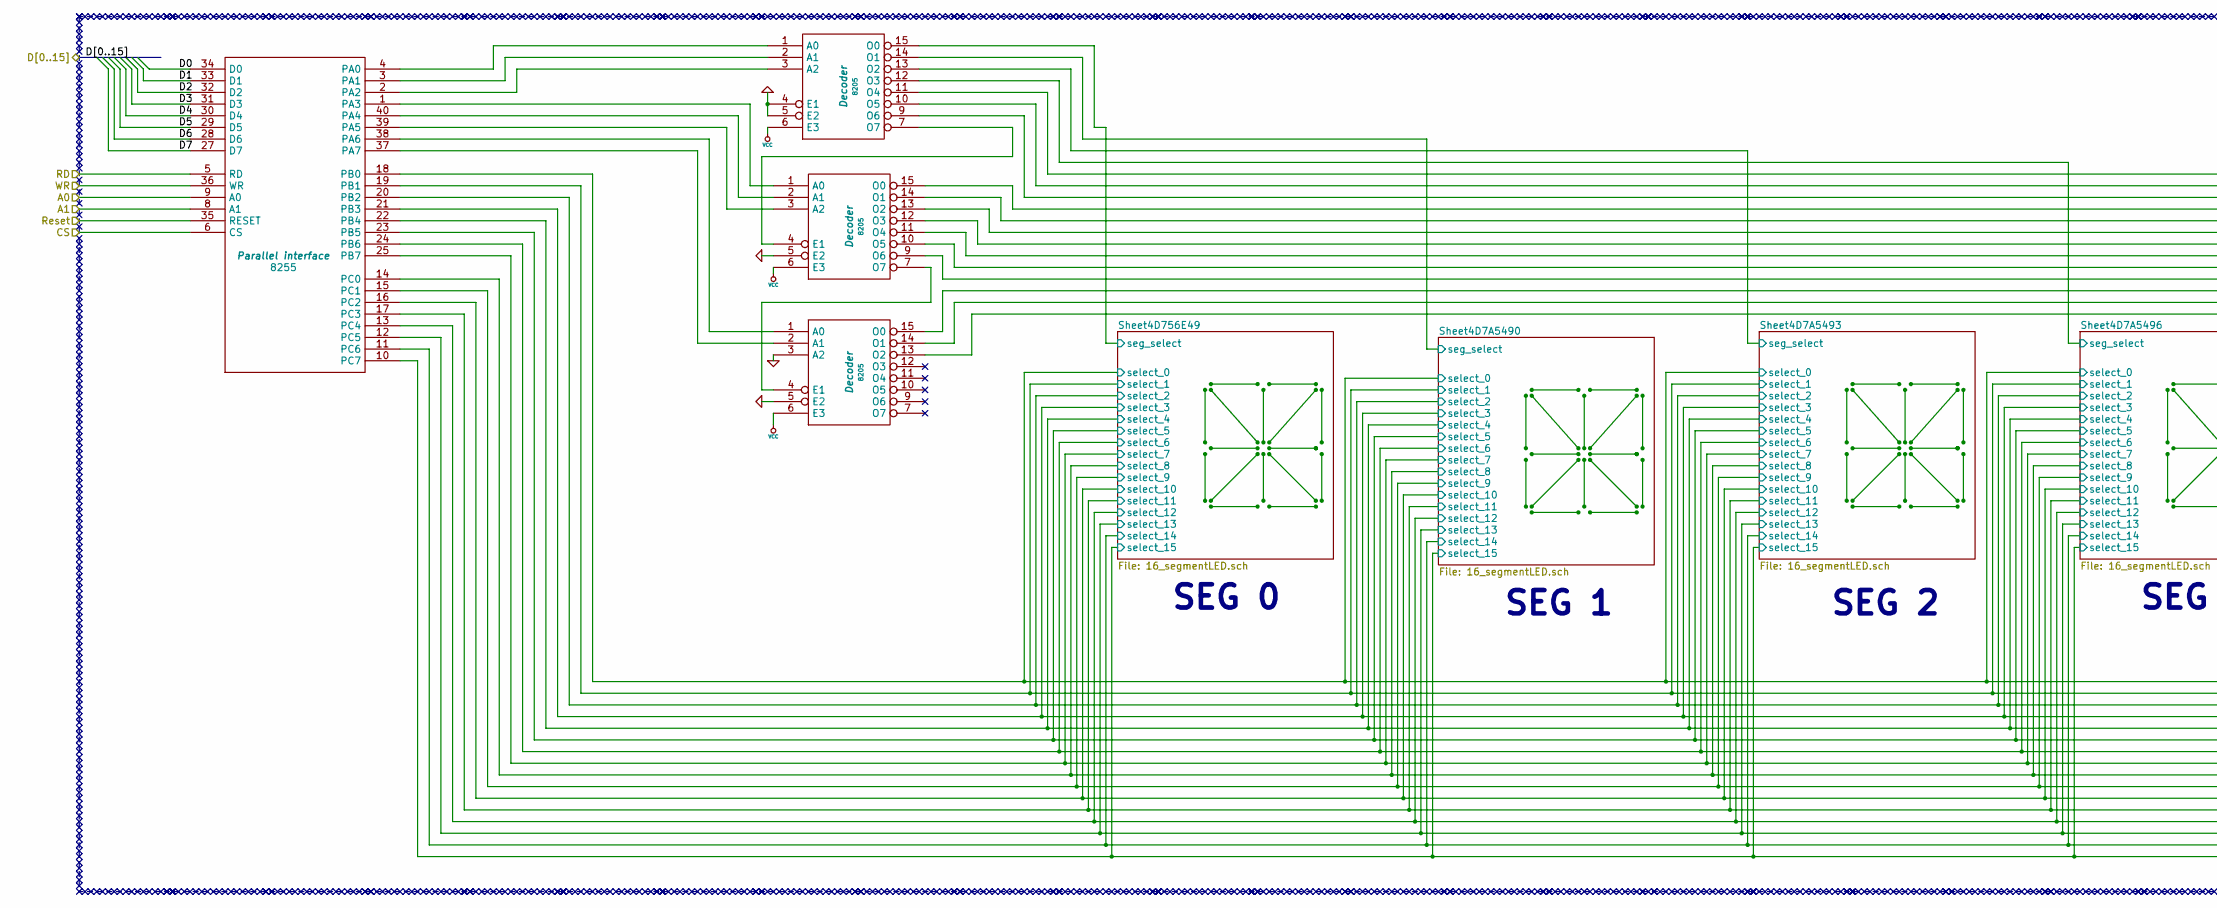
[picture p14: schematic Display.sch, part in row 1, column 1]

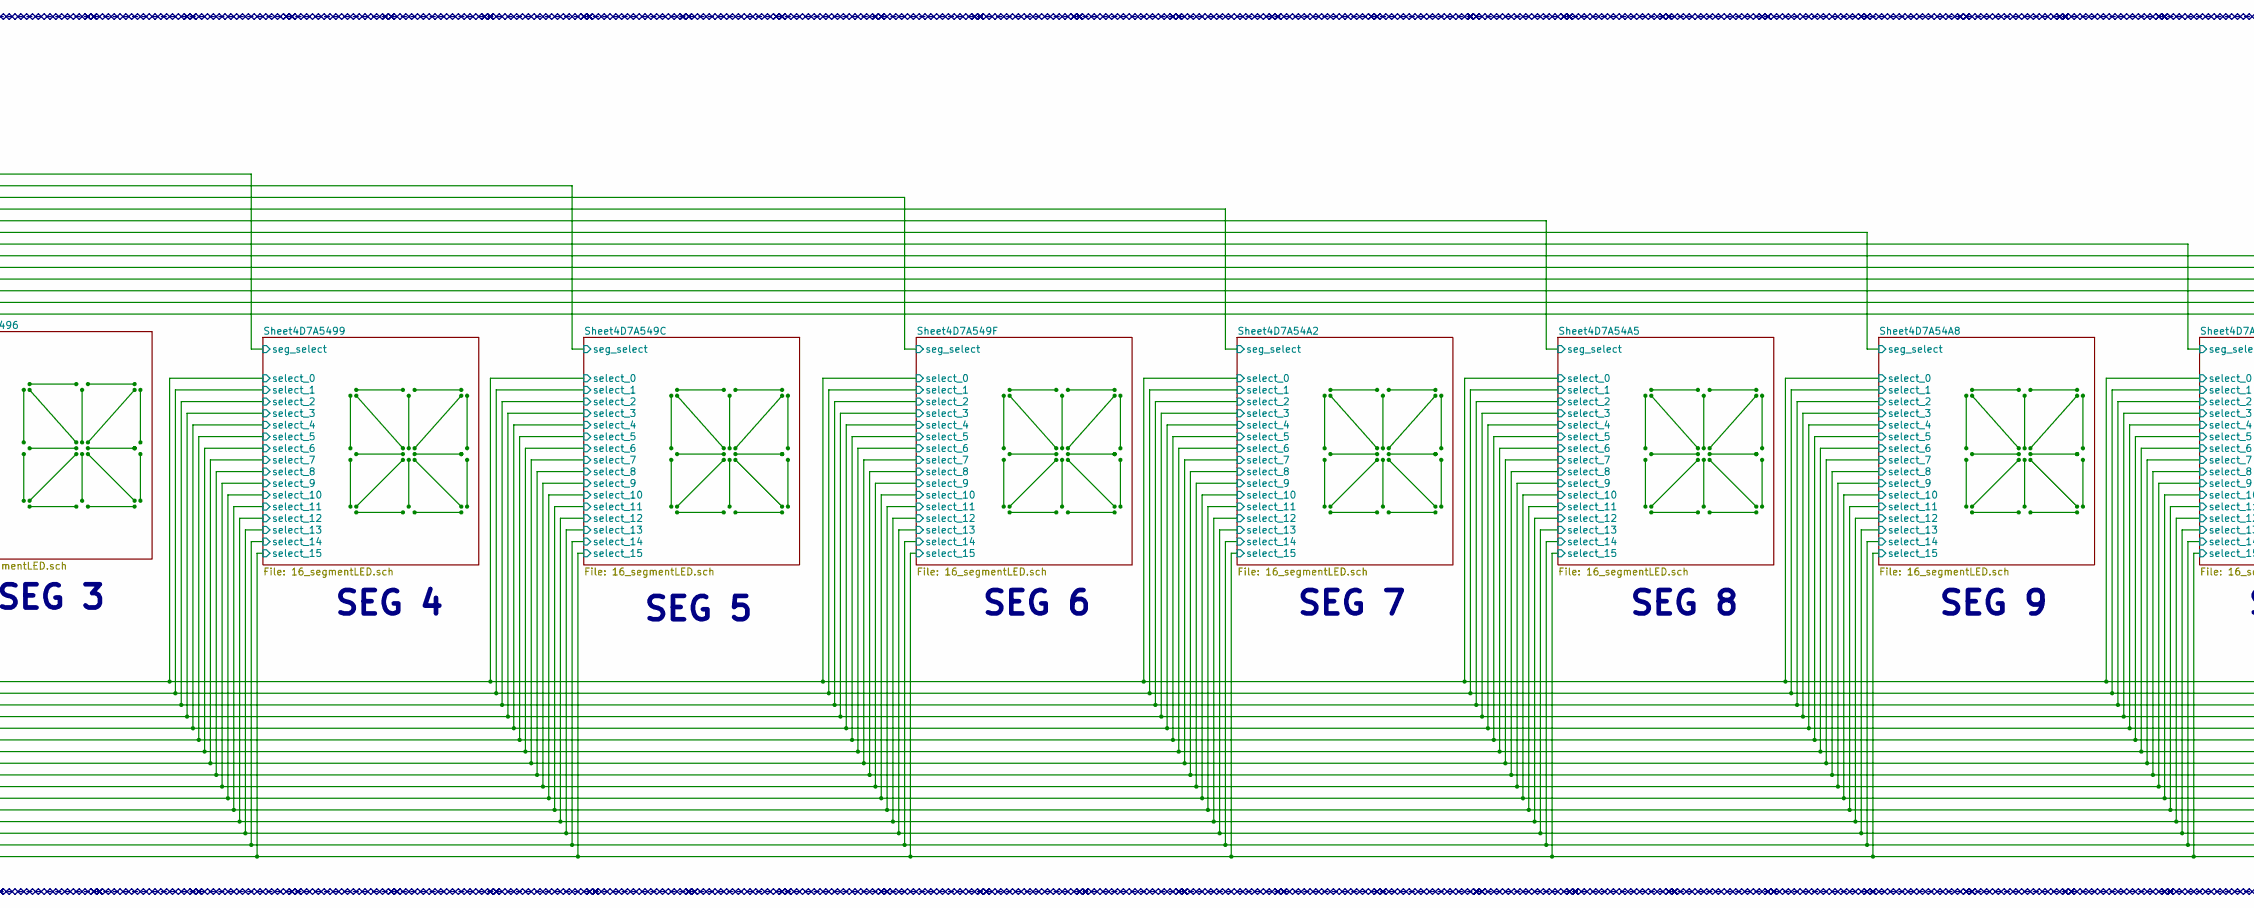
[picture p15: schematic Display.sch, part in row 1, column 2]

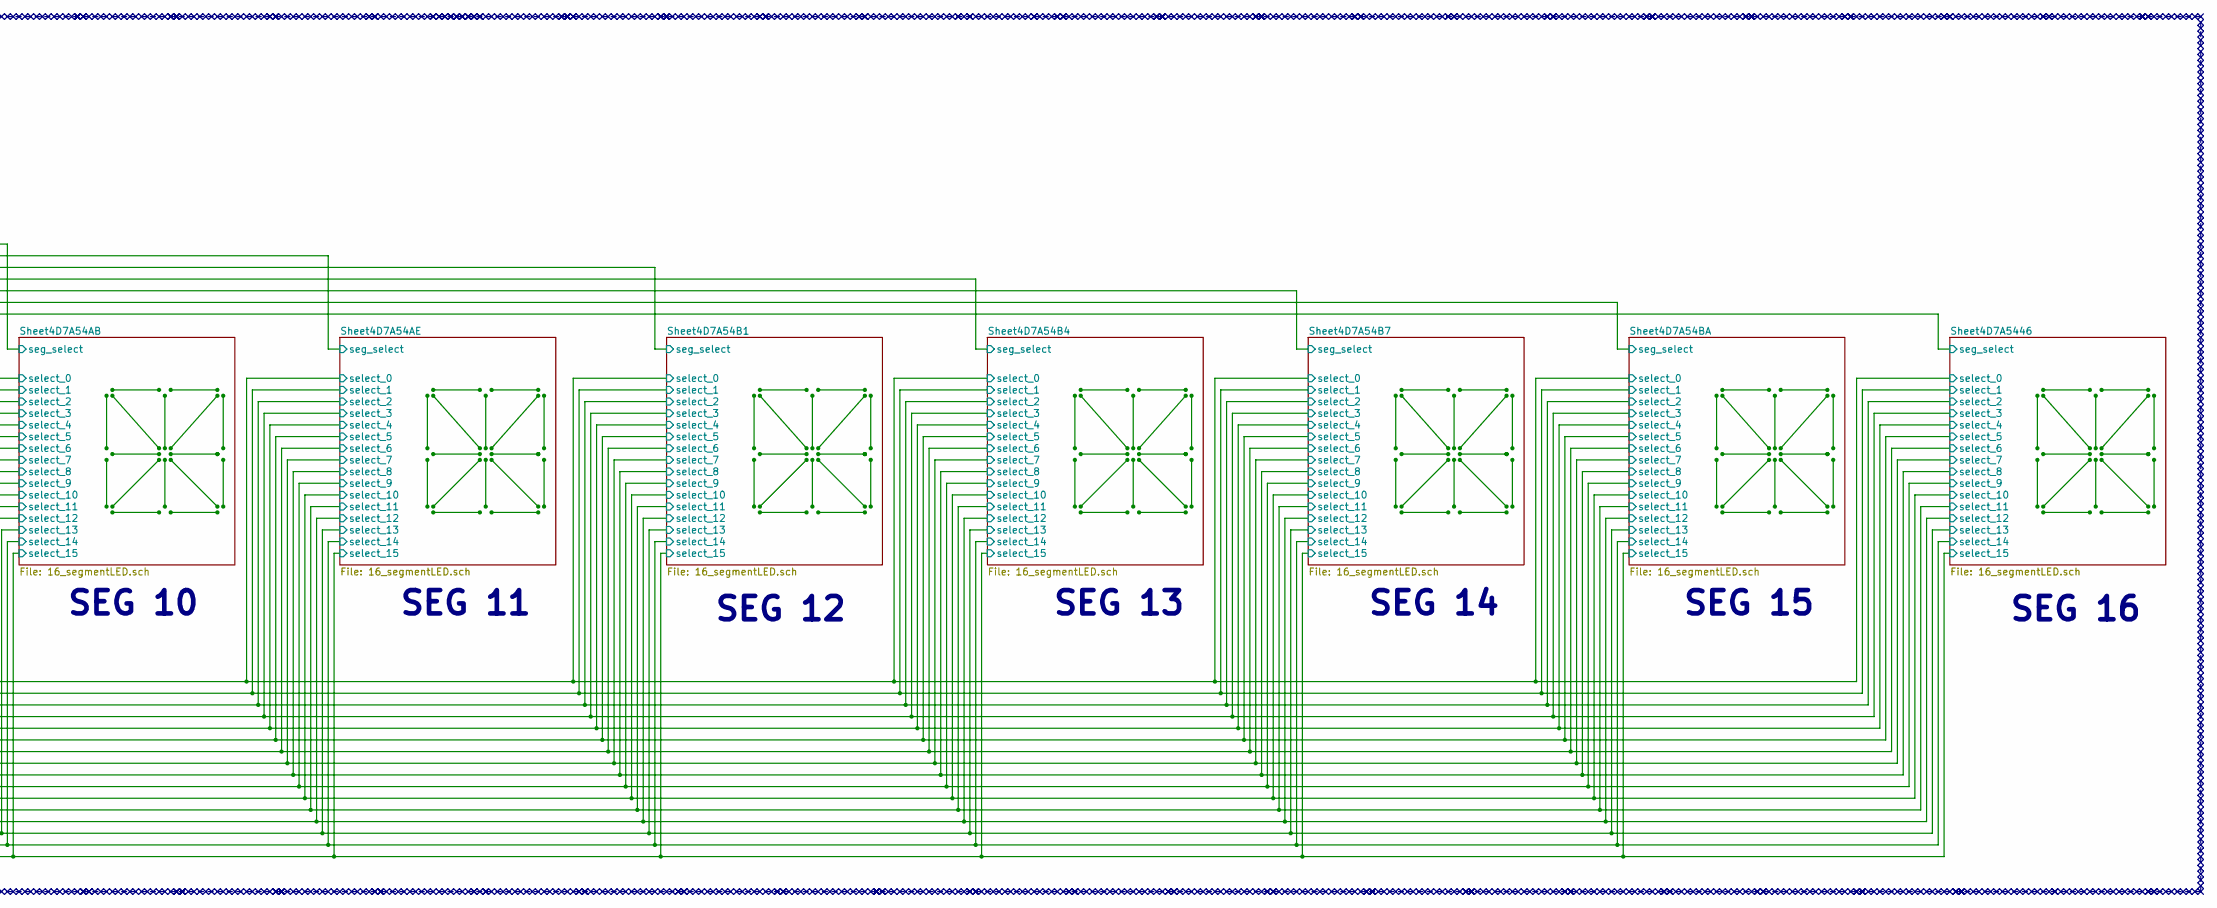
[picture p16: schematic Display.sch, part in row 1, column 3]

Parts:
U2: 8255; Parallel interface
decoder2, decoder3, decoder4: 8205; Decoder

Connections:
A0: U2.9 (A0)
A1: U2.8 (A1)
CS: U2.6 (CS)
D0: U2.34 (D0)
D1: U2.33 (D1)
D2: U2.32 (D2)
D3: U2.31 (D3)
D4: U2.30 (D4)
D5: U2.29 (D5)
D6: U2.28 (D6)
D7: U2.27 (D7)
GND: decoder2.4 (E1), decoder2.5 (E2), decoder3.5 (E2), decoder4.3 (A2), decoder4.5 (E2)
unnamed: U2.1 (PA3), decoder3.1 (A0)
unnamed: U2.2 (PA2), decoder2.3 (A2)
unnamed: U2.3 (PA1), decoder2.2 (A1)
unnamed: U2.4 (PA0), decoder2.1 (A0)
unnamed: U2.37 (PA7), decoder4.2 (A1)
unnamed: U2.38 (PA6), decoder4.1 (A0)
unnamed: U2.39 (PA5), decoder3.3 (A2)
unnamed: U2.40 (PA4), decoder3.2 (A1)
unnamed: decoder2.7 (O7), decoder3.4 (E1)
unnamed: decoder3.7 (O7), decoder4.4 (E1)
RD: U2.5 (RD)
Reset: U2.35 (RESET)
VCC: decoder2.6 (E3), decoder3.6 (E3), decoder4.6 (E3)
WR: U2.36 (WR)
seg_select: decoder2.9 (O6), decoder2.10 (O5), decoder2.11 (O4), decoder2.12 (O3), decoder2.13 (O2), decoder2.14 (O1), decoder2.15 (O0), decoder3.9 (O6), decoder3.10 (O5), decoder3.11 (O4), decoder3.12 (O3), decoder3.13 (O2), decoder3.14 (O1), decoder3.15 (O0), decoder4.13 (O2), decoder4.14 (O1), decoder4.15 (O0)
select_0: U2.18 (PB0)
select_1: U2.19 (PB1)
select_2: U2.20 (PB2)
select_3: U2.21 (PB3)
select_4: U2.22 (PB4)
select_5: U2.23 (PB5)
select_6: U2.24 (PB6)
select_7: U2.25 (PB7)
select_8: U2.14 (PC0)
select_9: U2.15 (PC1)
select_10: U2.16 (PC2)
select_11: U2.17 (PC3)
select_12: U2.13 (PC4)
select_13: U2.12 (PC5)
select_14: U2.11 (PC6)
select_15: U2.10 (PC7)

Notes on the sheet:
SEG 16
SEG 15
SEG 14
SEG 13
SEG 12
SEG 11
SEG 10
SEG 9
SEG 8
SEG 7
SEG 6
SEG 5
SEG 4
SEG 3
SEG 2
SEG 1
SEG 0
