srfunksensei/MIPS/source/8086/kasa8086/Keyboard8086.sch

## KiCad design source/8086/kasa8086/Keyboard8086.sch (2018-07-15)

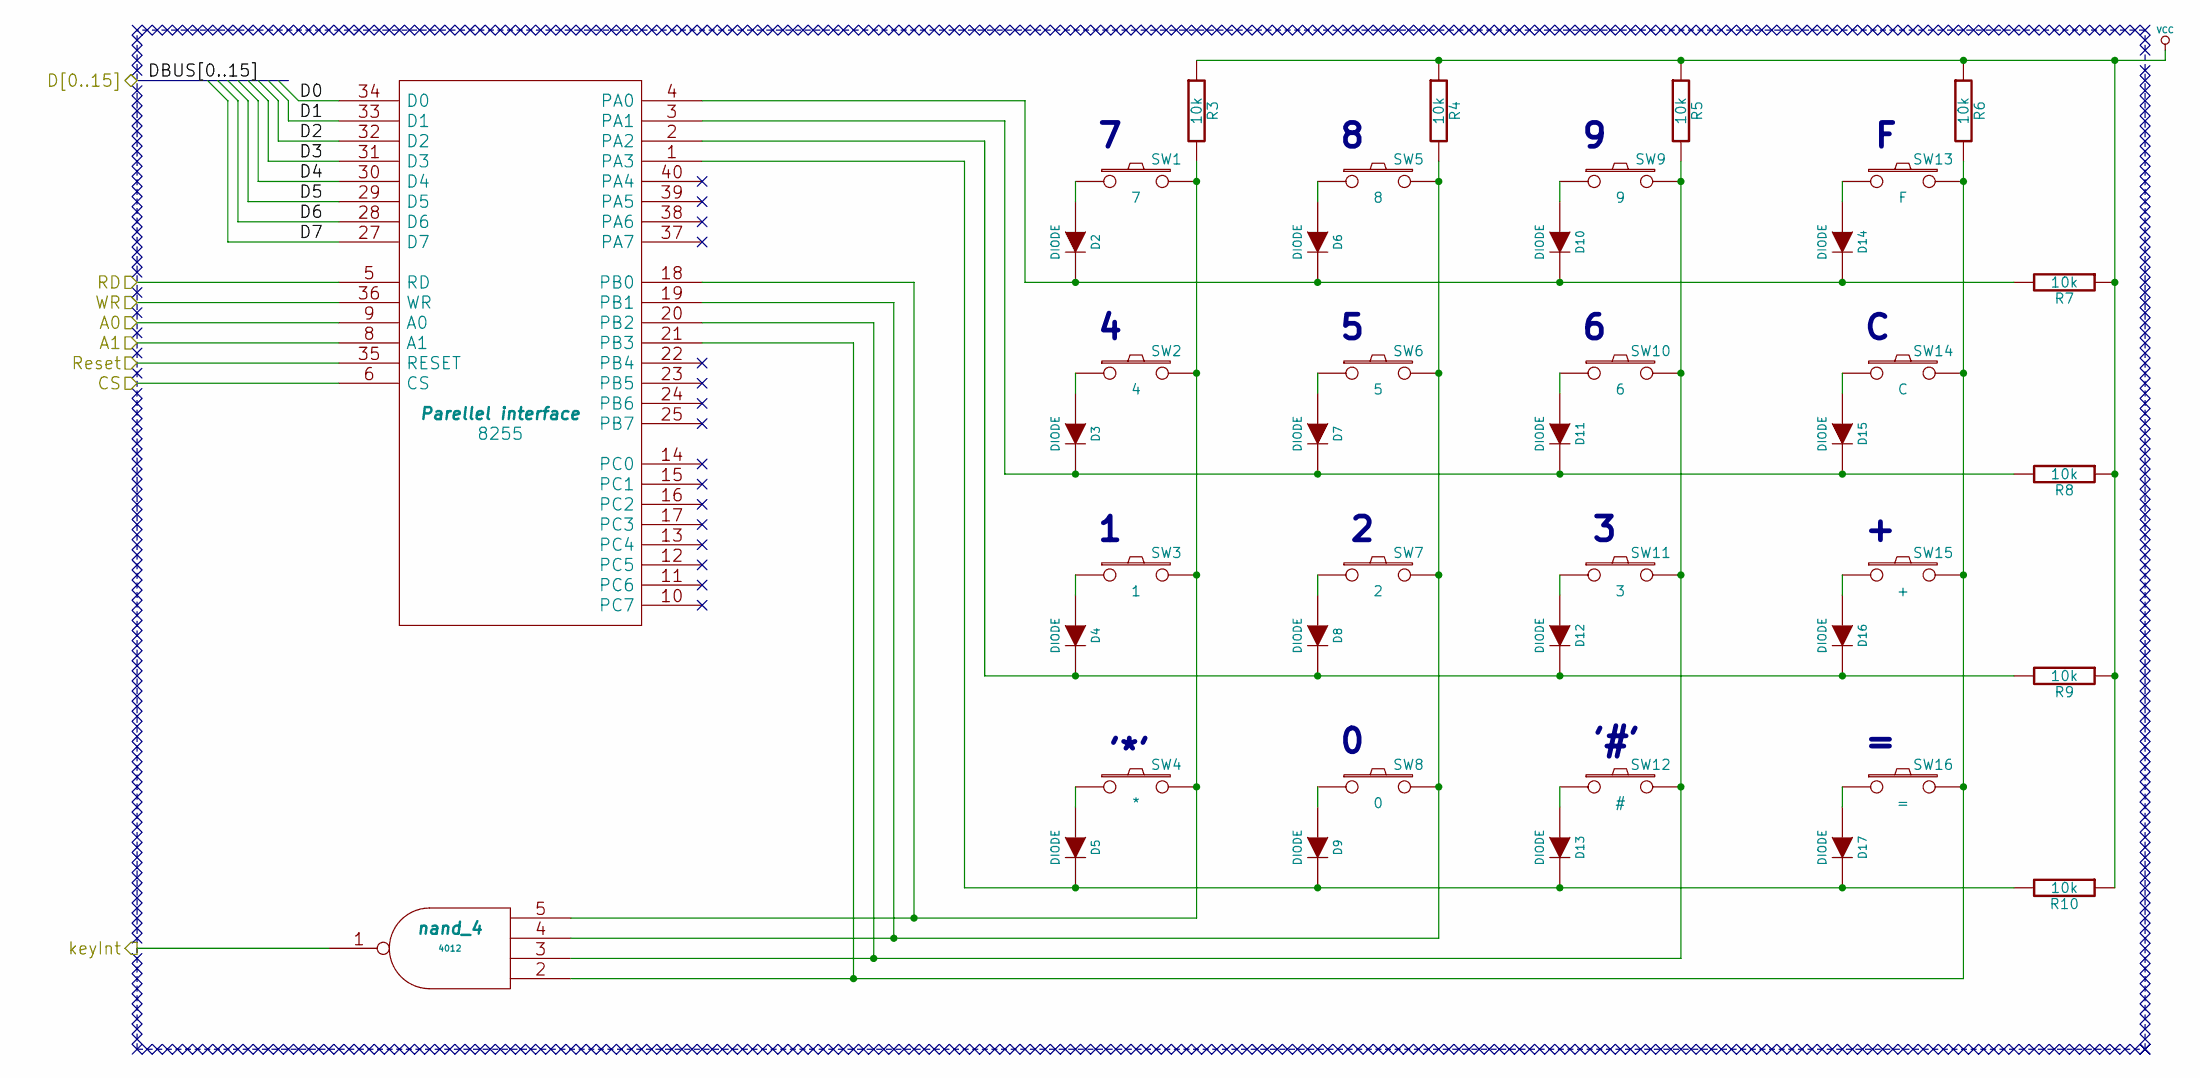
[picture p17: schematic Keyboard8086.sch]

Parts:
D2, D3, D4, D5, D6, D7, D8, D9, D10, D11, D12, D13, D14, D15, D16, D17: DIODE
R3, R4, R5, R6, R7, R8, R9, R10: 10k
SW1: 7
SW2: 4
SW3: 1
SW4: *
SW5: 8
SW6: 5
SW7: 2
SW8: 0
SW9: 9
SW10: 6
SW11: 3
SW12: #
SW13: F
SW14: C
SW15: +
SW16: =
U1: 4012; nand_4
parallel_interface2: 8255; Parellel interface

Connections:
A0: parallel_interface2.9 (A0)
A1: parallel_interface2.8 (A1)
CS: parallel_interface2.6 (CS)
D0: parallel_interface2.34 (D0)
D1: parallel_interface2.33 (D1)
D2: parallel_interface2.32 (D2)
D3: parallel_interface2.31 (D3)
D4: parallel_interface2.30 (D4)
D5: parallel_interface2.29 (D5)
D6: parallel_interface2.28 (D6)
D7: parallel_interface2.27 (D7)
unnamed: D2.1 (A), SW1.1
unnamed: D3.1 (A), SW2.1
unnamed: D4.1 (A), SW3.1
unnamed: D5.1 (A), SW4.1
unnamed: D6.1 (A), SW5.1
unnamed: D7.1 (A), SW6.1
unnamed: D8.1 (A), SW7.1
unnamed: D9.1 (A), SW8.1
unnamed: D10.1 (A), SW9.1
unnamed: D2.2 (K), D6.2 (K), D10.2 (K), D14.2 (K), R7.2, parallel_interface2.4 (PA0)
unnamed: D11.1 (A), SW10.1
unnamed: D3.2 (K), D7.2 (K), D11.2 (K), D15.2 (K), R8.2, parallel_interface2.3 (PA1)
unnamed: D12.1 (A), SW11.1
unnamed: D4.2 (K), D8.2 (K), D12.2 (K), D16.2 (K), R9.2, parallel_interface2.2 (PA2)
unnamed: D13.1 (A), SW12.1
unnamed: D5.2 (K), D9.2 (K), D13.2 (K), D17.2 (K), R10.2, parallel_interface2.1 (PA3)
unnamed: D14.1 (A), SW13.1
unnamed: D15.1 (A), SW14.1
unnamed: D16.1 (A), SW15.1
unnamed: D17.1 (A), SW16.1
unnamed: R3.2, SW1.2, SW2.2, SW3.2, SW4.2, U1.5, parallel_interface2.18 (PB0)
unnamed: R4.2, SW5.2, SW6.2, SW7.2, SW8.2, U1.4, parallel_interface2.19 (PB1)
unnamed: R5.2, SW9.2, SW10.2, SW11.2, SW12.2, U1.3, parallel_interface2.20 (PB2)
unnamed: R6.2, SW13.2, SW14.2, SW15.2, SW16.2, U1.2, parallel_interface2.21 (PB3)
RD: parallel_interface2.5 (RD)
Reset: parallel_interface2.35 (RESET)
VCC: R3.1, R4.1, R5.1, R6.1, R7.1, R8.1, R9.1, R10.1
WR: parallel_interface2.36 (WR)
keyInt: U1.1

Notes on the sheet:
'#'
'*'
